Lucas-el-pato/FC-DRON-P3/README.md

# FC-DRON-P3 - P4
PCB para Control de vuelo de un Dron para la materia de Proyecto 3 y Proyecto 4 por Lucas Garcia e Hernan Ibarra
