Lucas-el-pato/FC-DRON-P3/Esquematico_1/Footprints/BMP388/BMP388.step

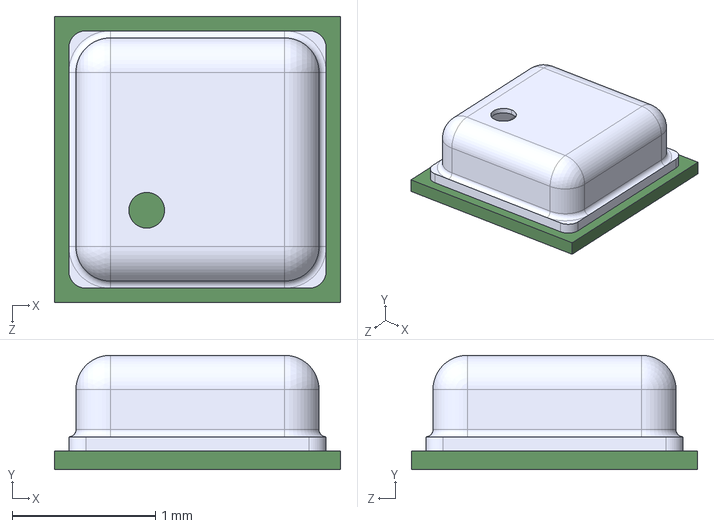
[picture p1: CAD file, 2026-02-21]
Esquematico_1/Footprints/BMP388/BMP388.step
2.00 x 0.8 x 2.00 mm
