Lucas-el-pato/FC-DRON-P3/Esquematico_1/Footprints/ICM_42688_P/ICM-42688-P.step

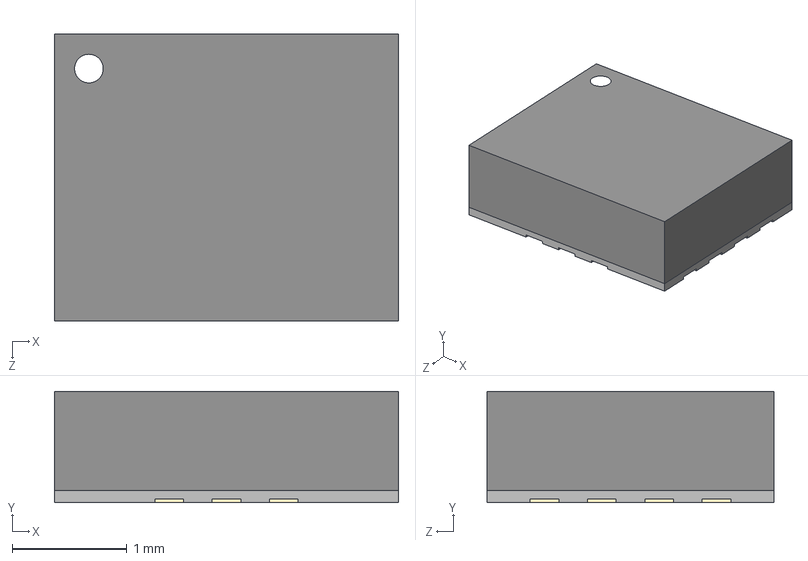
[picture p2: CAD file, 2026-02-24]
Esquematico_1/Footprints/ICM_42688_P/ICM-42688-P.step
3.00 x 0.97 x 2.50 mm
