Lucas-el-pato/FC-DRON-P3/Esquematico_1/Footprints/LIB_ABMM-8.000MHZ-D-4-T/ABMM-8.000MHZ-D-4-T/3D/ABMM-8.000MHZ-D-4-T.stp

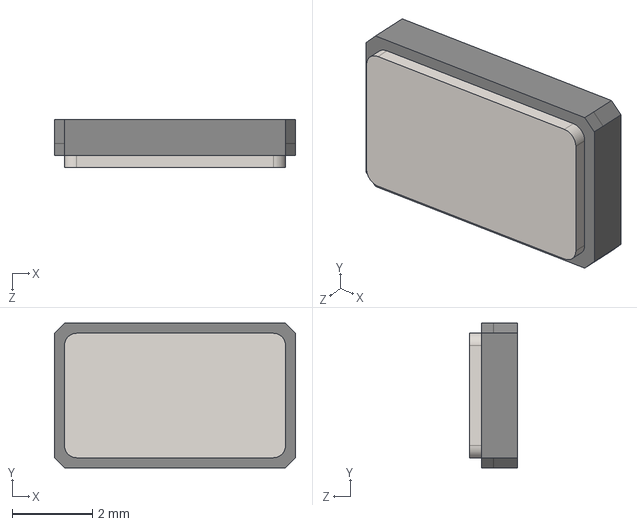
[picture p3: CAD file, 2026-03-03]
Esquematico_1/Footprints/LIB_ABMM-8.000MHZ-D-4-T/ABMM-8.000MHZ-D-4-T/3D/ABMM-8.000MHZ-D-4-T.stp
6.00 x 3.60 x 1.20 mm
