Lucas-el-pato/FC-DRON-P3/Esquematico_1/Footprints/LIB_AP2112K-3.3TRG1/AP2112K-3.3TRG1/3D/AP2112K-3.3TRG1.stp

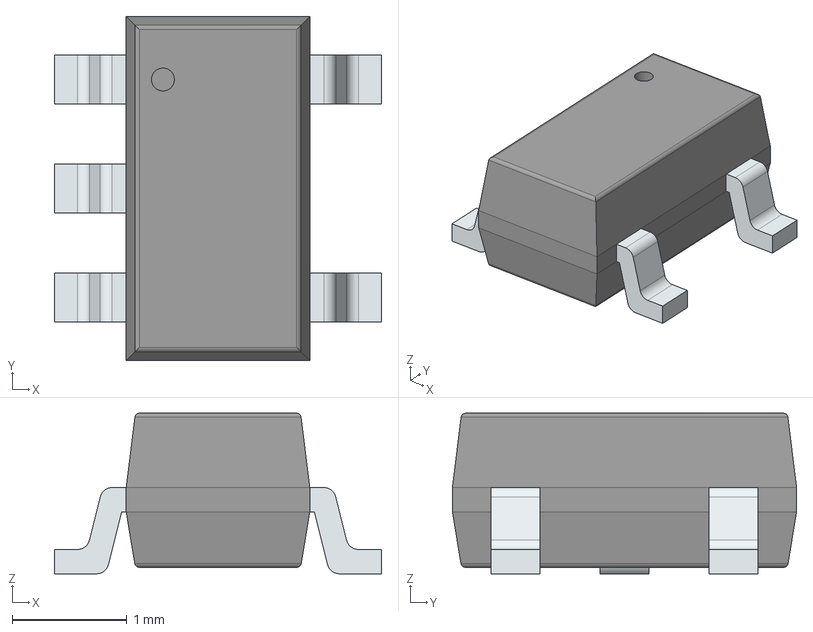
[picture p4: CAD file, 2026-03-10]
Esquematico_1/Footprints/LIB_AP2112K-3.3TRG1/AP2112K-3.3TRG1/3D/AP2112K-3.3TRG1.stp
2.85 x 3.00 x 1.40 mm
PinsArrayL
PinsArrayR
