Lucas-el-pato/FC-DRON-P3/Esquematico_1/Footprints/LIB_MAX-M10M-00B/MAX-M10M-00B/3D/MAX-M10M-00B.stp

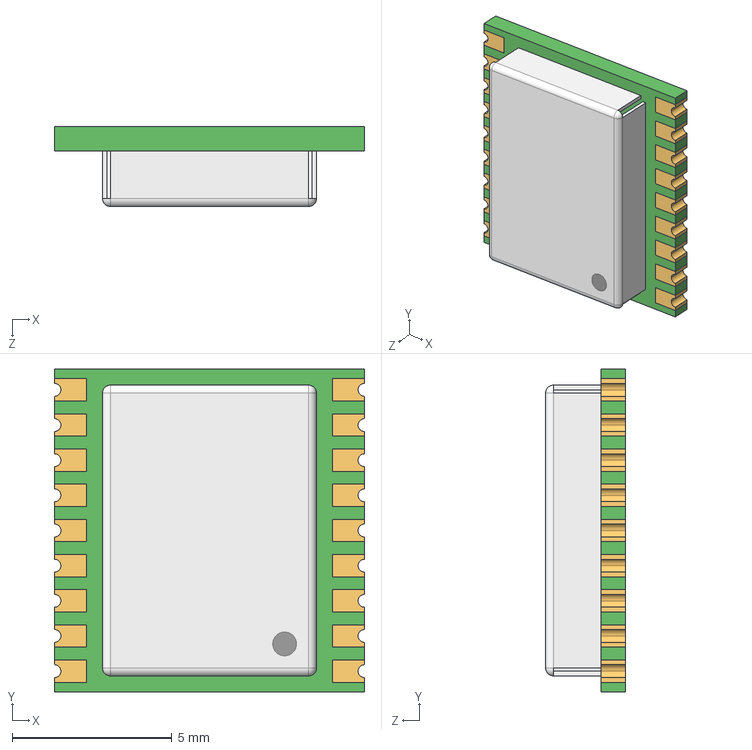
[picture p5: CAD file, 2026-02-21]
Esquematico_1/Footprints/LIB_MAX-M10M-00B/MAX-M10M-00B/3D/MAX-M10M-00B.stp
9.70 x 10.1 x 2.50 mm
