Lucas-el-pato/FC-DRON-P3/Esquematico_1/Footprints/LIB_USB4940-00-A/ul_2295018-2/c-2295018-2-b-3d.stp

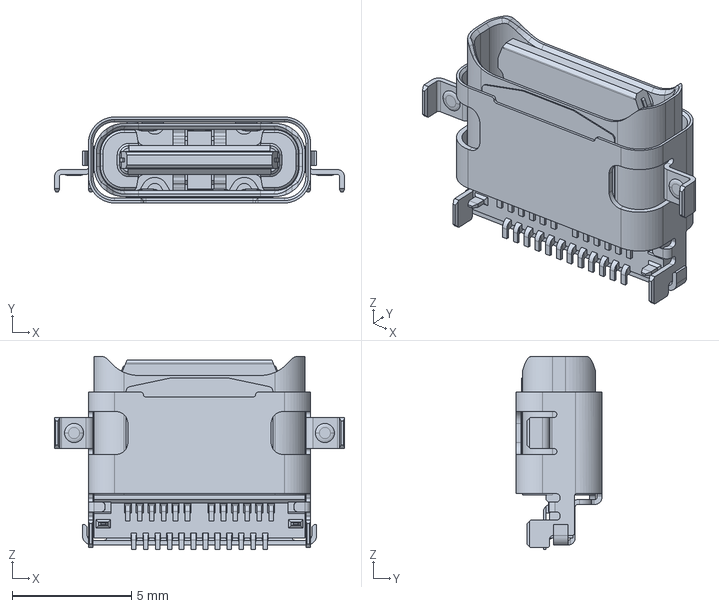
[picture p6: CAD file, 2026-03-16]
Esquematico_1/Footprints/LIB_USB4940-00-A/ul_2295018-2/c-2295018-2-b-3d.stp
12.1 x 3.60 x 8.10 mm
