Lucas-el-pato/FC-DRON-P3/Esquematico_1/Footprints/LIB_USB4940-00-A/USB4940-00-A/3D/USB4940-00-A.stp

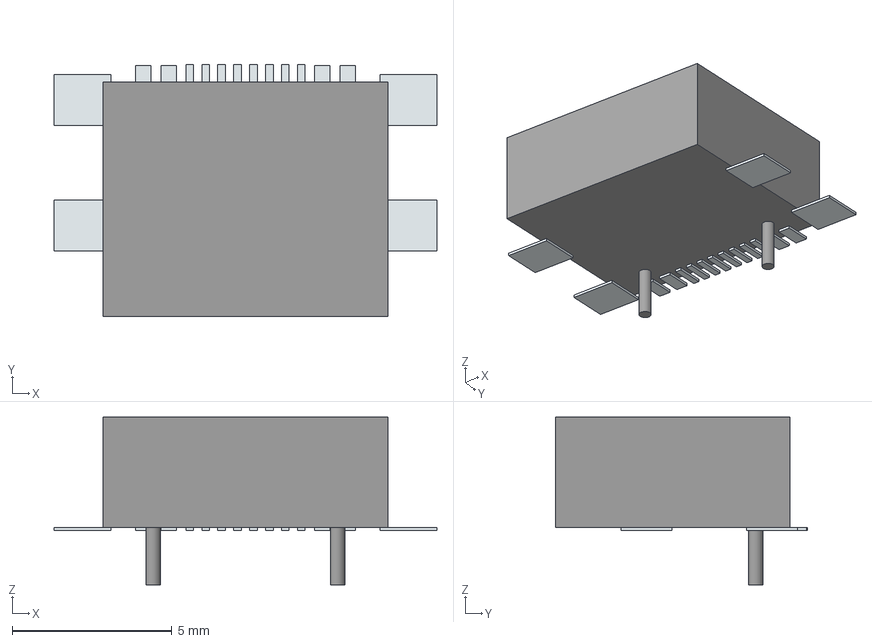
[picture p7: CAD file, 2026-03-11]
Esquematico_1/Footprints/LIB_USB4940-00-A/USB4940-00-A/3D/USB4940-00-A.stp
12.0 x 7.90 x 5.26 mm
Pins
Lugs
