Lucas-el-pato/FC-DRON-P3/Esquematico_1/Footprints/MAX_M10S_00B/MAX-M10S-00B.STEP

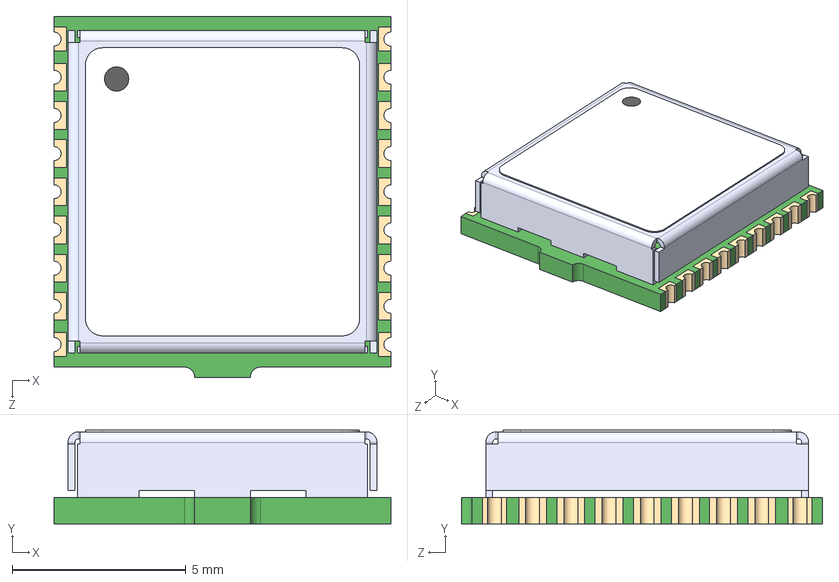
[picture p8: CAD file, 2026-03-06]
Esquematico_1/Footprints/MAX_M10S_00B/MAX-M10S-00B.STEP
9.70 x 2.70 x 10.4 mm
