Lucas-el-pato/FC-DRON-P3/Esquematico_1/Footprints/Tokmas ICM-42688-PC/LGA14_2P5X3X0P91_TDK.step

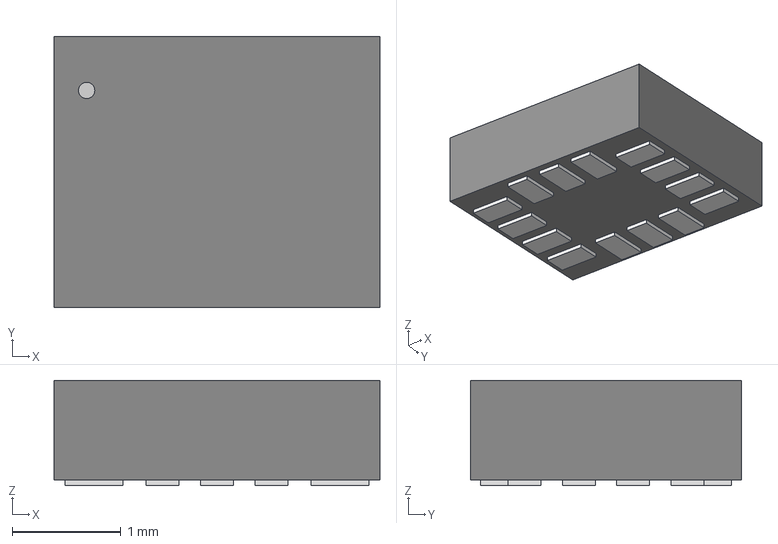
[picture p9: CAD file, 2026-03-16]
Esquematico_1/Footprints/Tokmas ICM-42688-PC/LGA14_2P5X3X0P91_TDK.step
3.00 x 2.49 x 0.968 mm
