Lucas-el-pato/FC-DRON-P3/Esquematico_1/Footprints/ul_ECS-80-12-30BQ-JES-TR/ECS-80-12_ECS.step

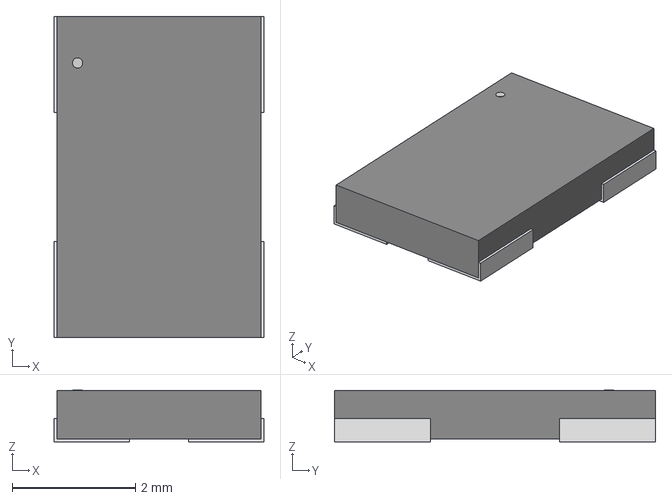
[picture p10: CAD file, 2026-03-10]
Esquematico_1/Footprints/ul_ECS-80-12-30BQ-JES-TR/ECS-80-12_ECS.step
3.40 x 5.21 x 0.841 mm
