Lucas-el-pato/FC-DRON-P3/Esquematico_1/Footprints/ul_LSM6DSV16XTR/LGA-14L_STM.step

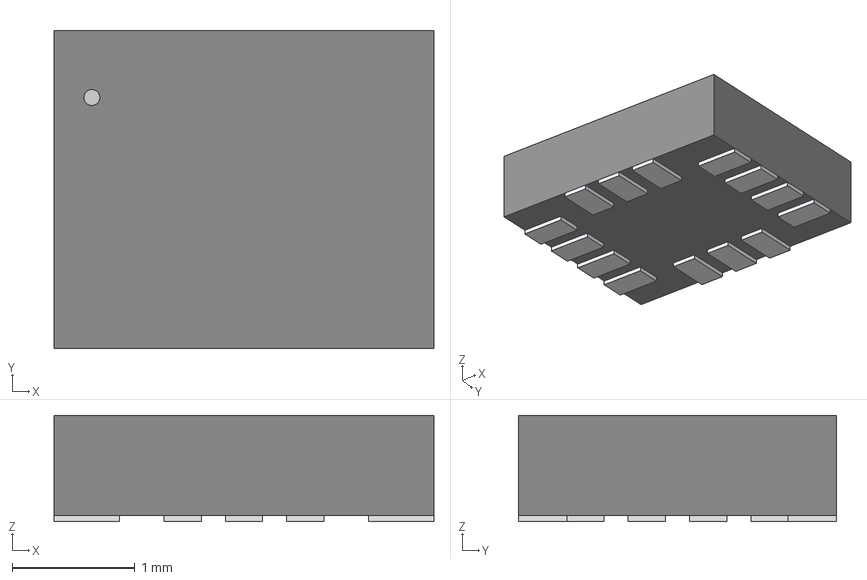
[picture p11: CAD file, 2026-04-01]
Esquematico_1/Footprints/ul_LSM6DSV16XTR/LGA-14L_STM.step
3.10 x 2.59 x 0.866 mm
