Lucas-el-pato/FC-DRON-P3/Esquematico_1/Footprints/ul_MMC5983MA/MMC5983MA_MEM.step

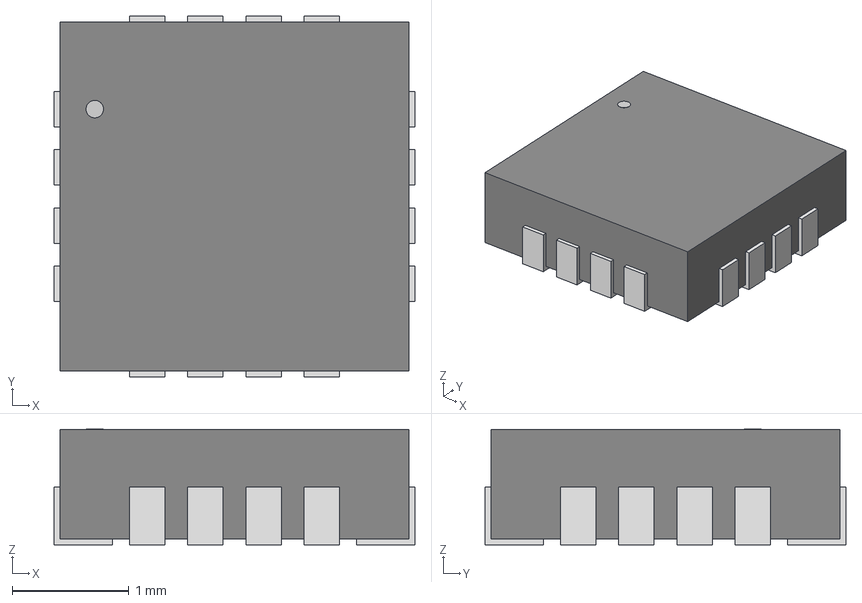
[picture p12: CAD file, 2026-03-29]
Esquematico_1/Footprints/ul_MMC5983MA/MMC5983MA_MEM.step
3.10 x 3.10 x 0.993 mm
