Lucas-el-pato/FC-DRON-P3/Esquematico_1/Footprints/ul_NX3215SA-32-768K-STD-MUA-9/ul_NX3215SA-32-768K-STD-MUA-9 (1)/XTAL_NX3215SA_NDK.step

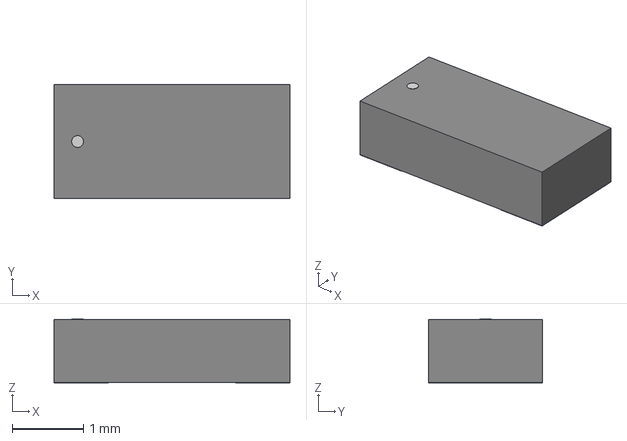
[picture p13: CAD file, 2026-03-10]
Esquematico_1/Footprints/ul_NX3215SA-32-768K-STD-MUA-9/ul_NX3215SA-32-768K-STD-MUA-9 (1)/XTAL_NX3215SA_NDK.step
3.30 x 1.60 x 0.892 mm
