Lucas-el-pato/FC-DRON-P3/Esquematico_1/Footprints/MOLEX 5033981892/ul_5033981892/5033981892.stp

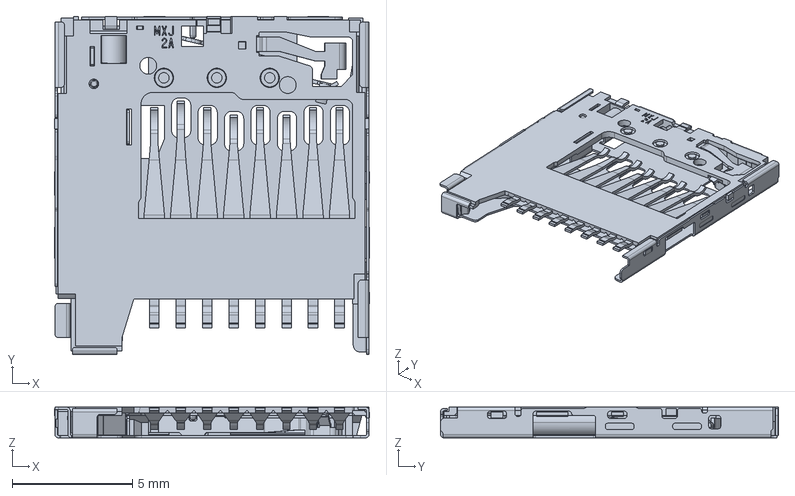
[picture p14: CAD file, 2026-03-16]
Esquematico_1/Footprints/MOLEX 5033981892/ul_5033981892/5033981892.stp
13.1 x 14.0 x 1.28 mm
