Lucas-el-pato/FC-DRON-P3/(list of files, cad)

Other CAD files:
Esquematico_1/Footprints/LIB_ABMM-8.000MHZ-D-4-T/ABMM-8.000MHZ-D-4-T/Allegro/abmm25000mhzb2t.psm
Esquematico_1/Footprints/LIB_ABMM-8.000MHZ-D-4-T/ABMM-8.000MHZ-D-4-T/DEHDL/abmm_8.000mhz_d_4_t/chips/chips.prt
Esquematico_1/Footprints/LIB_AP2112K-3.3TRG1/AP2112K-3.3TRG1/Allegro/sot95p285x140-5n.psm
Esquematico_1/Footprints/LIB_AP2112K-3.3TRG1/AP2112K-3.3TRG1/DEHDL/ap2112k_3.3trg1/chips/chips.prt
Esquematico_1/Footprints/LIB_USB4940-00-A/USB4940-00-A/Allegro/usb494000a.psm
Esquematico_1/Footprints/LIB_USB4940-00-A/USB4940-00-A/DEHDL/usb4940_00_a/chips/chips.prt
