Lucas-el-pato/FC-DRON-P3/(list of files, drawings)

Other design files:
Esquematico_1/Footprints/hanxia HX-TYPE-C 24P-1.6 USB C 3.2 REC, HORZ/HX-TYPE-C 24P-1.6 USB C 3.2 REC, HORZ1_HX-TYPE-C 24P-1.6 USB C 3.2 REC, HORZ.schdoc
Esquematico_1/Footprints/hanxia HX-TYPE-C 24P-1.6 USB C 3.2 REC, HORZ/k10/LGA-16_L3.0-W3.0-P0.50-BL_SQ.pcbdoc
Esquematico_1/Footprints/hanxia HX-TYPE-C 24P-1.6 USB C 3.2 REC, HORZ/k10/USB-C-SMD_C49261591.pcbdoc
Esquematico_1/Footprints/HYP 1TS003B-1400-3500A-CT/1TS003B-1400-3500A1_1TS003B-1400-3500A.schdoc
Esquematico_1/Footprints/HYP 1TS003B-1400-3500A-CT/k10/KEY-SMD_1TS003B.pcbdoc
Esquematico_1/Footprints/HYP 1TS003B-1400-3500A-CT/k10/LGA-16_L3.0-W3.0-P0.50-BL_SQ.pcbdoc
Esquematico_1/Footprints/LIB_AP2112K-3.3TRG1/AP2112K-3.3TRG1/Altium/AP2112K-3.3TRG1.SchLib
Esquematico_1/Footprints/LIB_AP2112K-3.3TRG1/AP2112K-3.3TRG1/Altium/SOT95P285X140-5N.PcbLib
Esquematico_1/Footprints/LIB_USB4940-00-A/USB4940-00-A/Altium/USB4940-00-A.SchLib
Esquematico_1/Footprints/LIB_USB4940-00-A/USB4940-00-A/Altium/USB494000A.PcbLib
Esquematico_1/Footprints/MOLEX 5033981892/503398-18921_503398-1892.schdoc
Esquematico_1/Footprints/MOLEX 5033981892/k10/LGA-16_L3.0-W3.0-P0.50-BL_SQ.pcbdoc
Esquematico_1/Footprints/MOLEX 5033981892/k10/TF-SMD_503398-1892.pcbdoc
Esquematico_1/Footprints/QMC5883P/k10/LGA-16_L3.0-W3.0-P0.50-BL_SQ.pcbdoc
Esquematico_1/Footprints/QMC5883P/QMC5883P1_QMC5883P.schdoc
Esquematico_1/Footprints/Tokmas ICM-42688-PC/ICM-42688-PC1_ICM-42688-PC.schdoc
Esquematico_1/Footprints/Tokmas ICM-42688-PC/k10/LGA-14_L3.0-W2.5-P0.50-TL.pcbdoc
