Lucas-el-pato/FC-DRON-P3/Esquematico_1/Esquematico_1.kicad_pcb

## KiCad design Esquematico_1/Esquematico_1.kicad_pcb (2026-04-23)

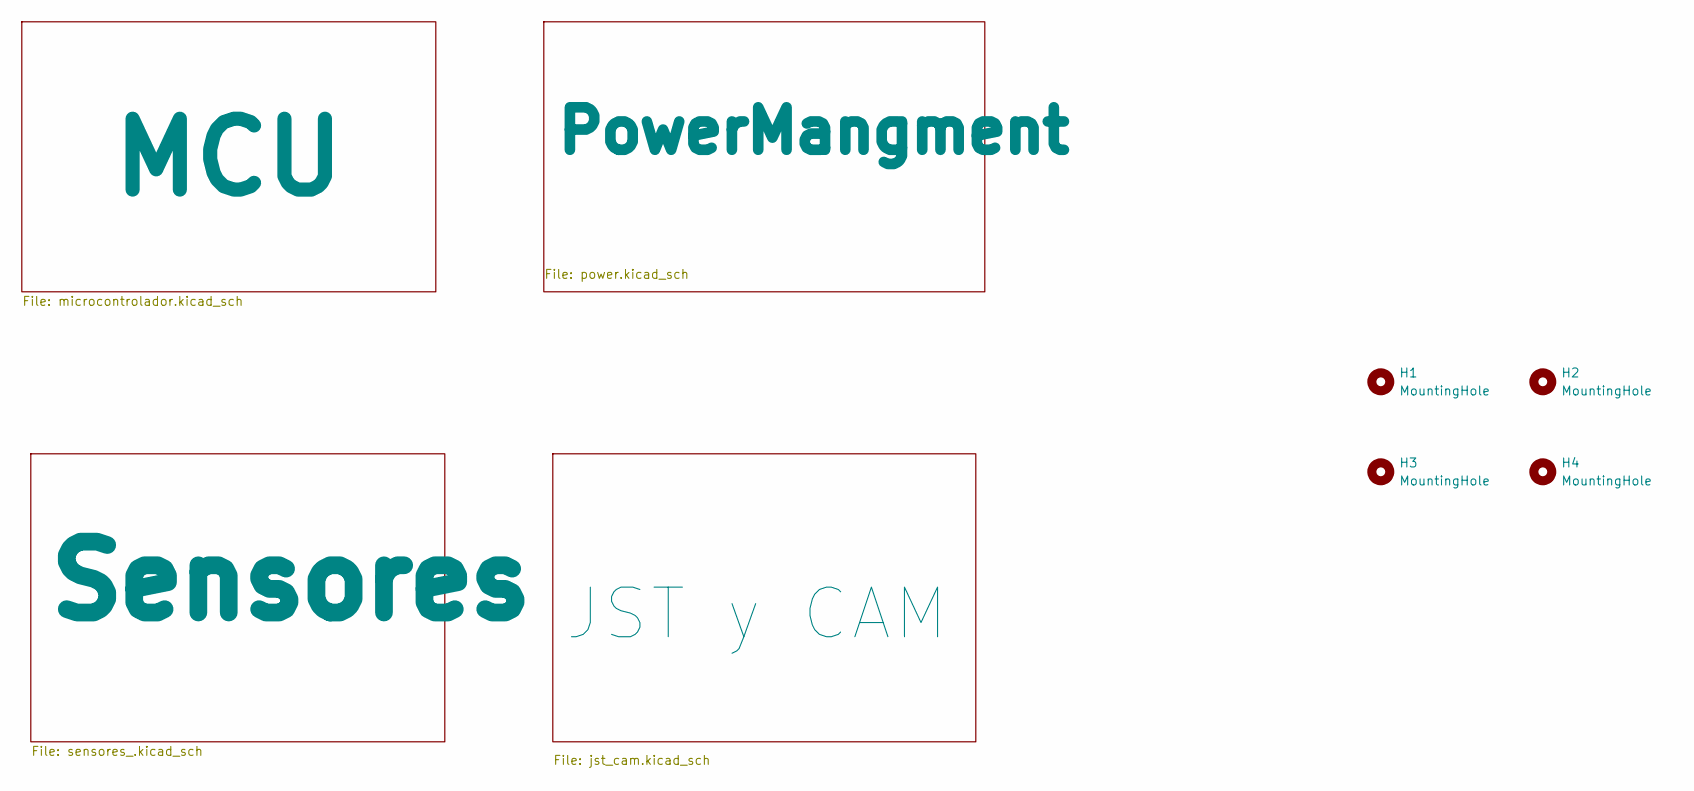
[picture p15: schematic Esquematico_1.kicad_sch]

Parts:
H1, H2, H3, H4: MountingHole; MountingHole_3.2mm_M3_Pad_Via

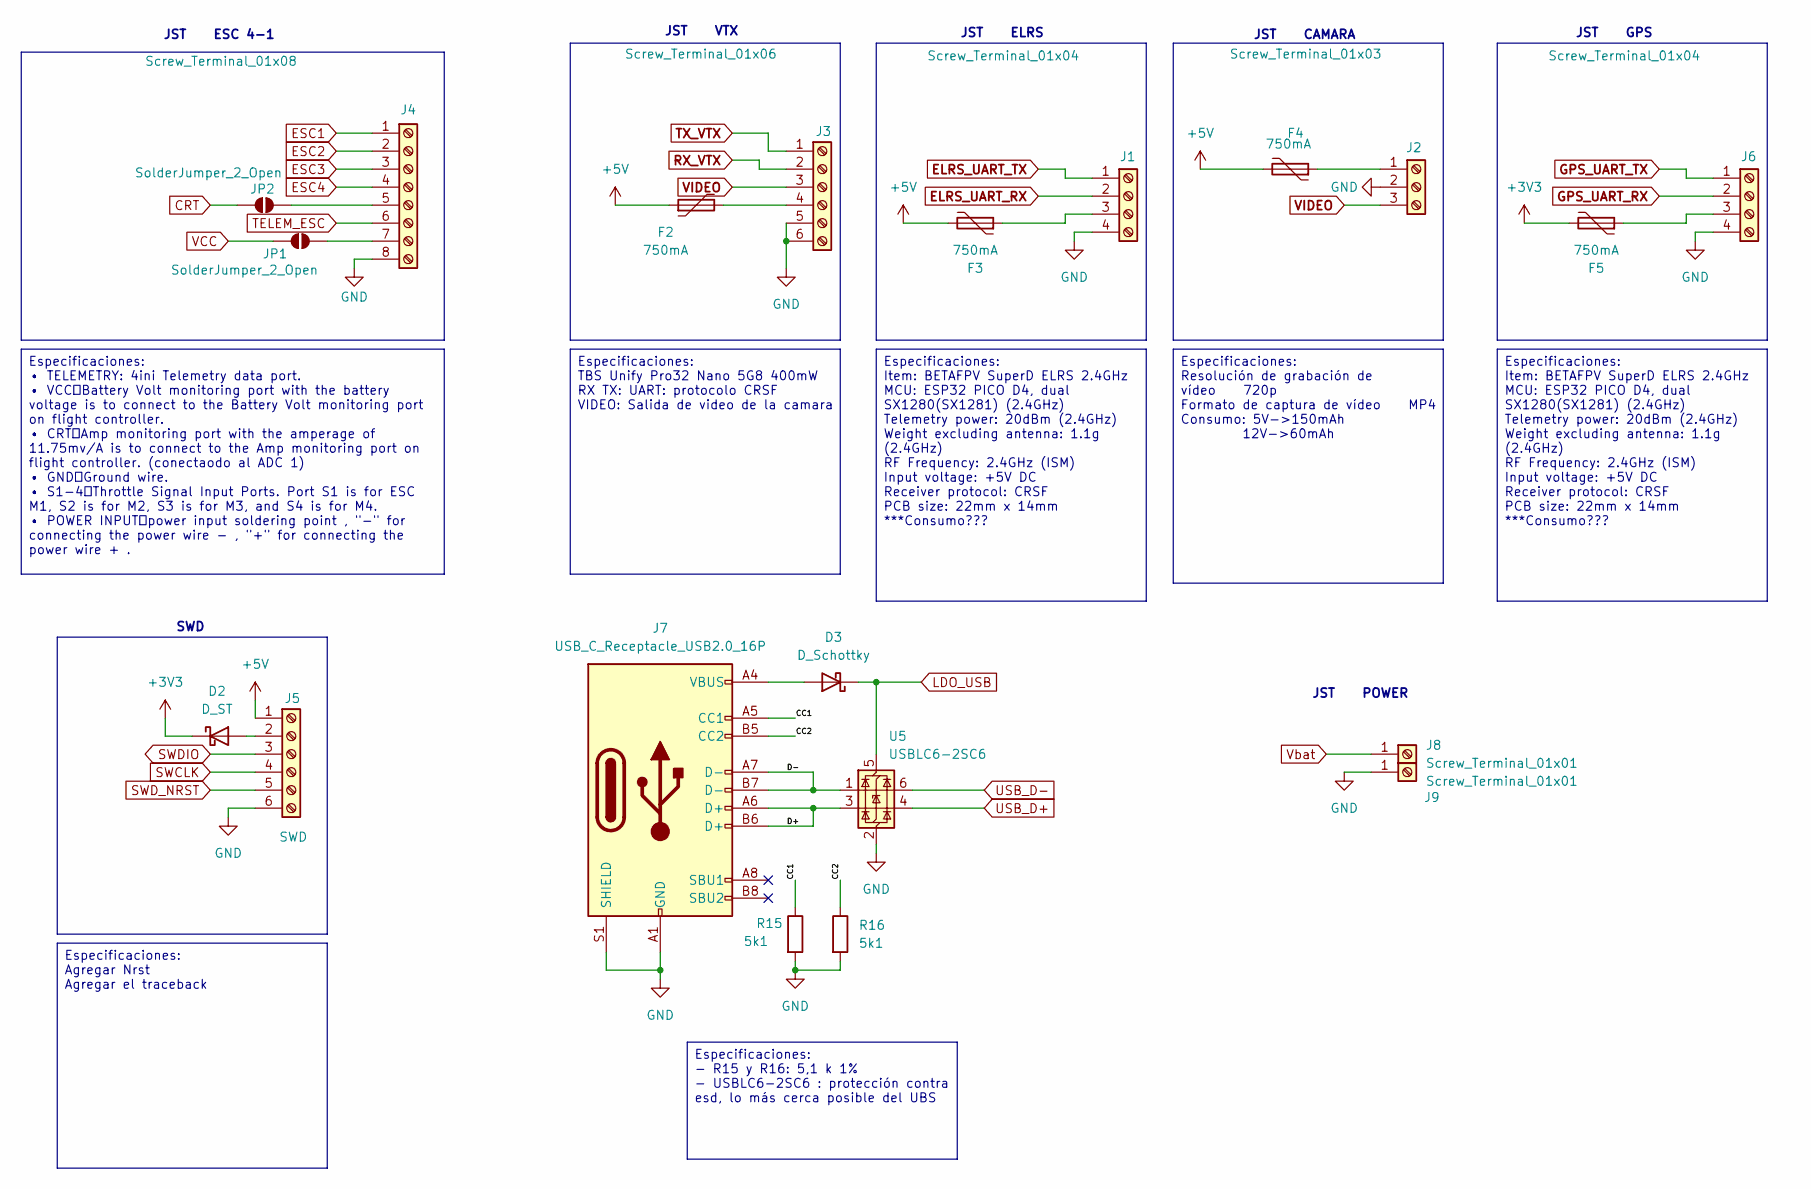
[picture p16: schematic jst_cam.kicad_sch]

Parts:
D2: D_ST; D_SOD-323_HandSoldering; LCSC Part Name C124187
D3: D_Schottky; D_SOD-323_HandSoldering; LCSC Part Name C124187
F2, F3, F4, F5: 750mA; C_0805_2012Metric_Pad1.18x1.45mm_HandSolder; LCSC Part Name C151146
J1, J6: Screw_Terminal_01x04; JST_SH_SM04B-SRSS-TB_1x04-1MP_P1.00mm_Horizontal; LCSC Part Name C160404
J2: Screw_Terminal_01x03; JST_SH_SM03B-SRSS-TB_1x03-1MP_P1.00mm_Horizontal; LCSC Part Name C160403
J3: Screw_Terminal_01x06; JST_SH_SM06B-SRSS-TB_1x06-1MP_P1.00mm_Horizontal; LCSC Part Name C160405
J4: Screw_Terminal_01x08; JST_SH_SM08B-SRSS-TB_1x08-1MP_P1.00mm_Horizontal; LCSC Part Name C160407
J5: SWD; PinHeader_1x06_P1.00mm_Vertical_SMD_Pin1Left
J7: USB_C_Receptacle_USB2.0_16P; USB494000A
J8, J9: Screw_Terminal_01x01; TestPoint_Pad_2.5x2.5mm
JP1, JP2: SolderJumper_2_Open; SolderJumper-2_P1.3mm_Open_RoundedPad1.0x1.5mm
R15, R16: 5k1; R_0805_2012Metric_Pad1.20x1.40mm_HandSolder; LCSC Part Name C2907269
U5: USBLC6-2SC6; SOT-23-6; LCSC Part Name C2969755

Connections:
+3V3: D2.1 (K), F5.2; also elsewhere on the board
/JST y CAM/CC1: J7.A5 (CC1), R15.1
/JST y CAM/CC2: J7.B5 (CC2), R16.1
/JST y CAM/D+: J7.A6 (D+), J7.B6 (D+), U5.3 (I/O2)
/JST y CAM/D-: J7.A7 (D-), J7.B7 (D-), U5.1 (I/O1)
CRT: JP2.2 (B); also elsewhere on the board
ELRS_UART_RX: J1.2; also elsewhere on the board
ELRS_UART_TX: J1.1; also elsewhere on the board
ESC1: J4.1; also elsewhere on the board
ESC2: J4.2; also elsewhere on the board
ESC3: J4.3; also elsewhere on the board
ESC4: J4.4; also elsewhere on the board
GND: J1.4, J2.2, J3.5, J3.6, J4.8, J5.6, J6.4, J7.A1 (GND), J7.A12 (GND), J7.B1 (GND), J7.B12 (GND), J7.S1 (SHIELD), J9.1, R15.2, R16.2, U5.2 (GND); also elsewhere on the board
GPS_UART_RX: J6.2; also elsewhere on the board
GPS_UART_TX: J6.1; also elsewhere on the board
LDO_USB: D3.1 (K), F2.1, F3.2, F4.2, J5.1, U5.5 (VBUS); also elsewhere on the board
unnamed: D2.2 (A), J5.2
unnamed: D3.2 (A), J7.A4 (VBUS), J7.A9 (VBUS), J7.B4 (VBUS), J7.B9 (VBUS)
unnamed: F3.1, J1.3
unnamed: F4.1, J2.1
unnamed: F2.2, J3.4
unnamed: J4.5, JP2.1 (A)
unnamed: J4.7, JP1.1 (A)
unnamed: F5.1, J6.3
RX_VTX: J3.2; also elsewhere on the board
SWCLK: J5.4; also elsewhere on the board
SWDIO: J5.3; also elsewhere on the board
SWD_NRST: J5.5; also elsewhere on the board
TELEM_ESC: J4.6; also elsewhere on the board
TX_VTX: J3.1; also elsewhere on the board
USB_D+: U5.4 (I/O2); also elsewhere on the board
USB_D-: U5.6 (I/O1); also elsewhere on the board
VCC: J8.1, JP1.2 (B); also elsewhere on the board
VIDEO: J2.3, J3.3

Notes on the sheet:
JST GPS
JST CAMARA
JST POWER
JST VTX
JST ELRS
SWD
JST ESC 4-1
Especificaciones: Agregar Nrst Agregar el traceback
Especificaciones: Item: BETAFPV SuperD ELRS 2.4GHz MCU: ESP32 PICO D4, dual SX1280(SX1281) (2.4GHz) Telemetry power: 20dBm (2.4GHz) Weight excluding antenna: 1.1g (2.4GHz) RF Frequency: 2.4GHz (ISM) Input voltage: +5V DC Receiver protocol: CRSF PCB size: 22mm x 14mm ***Consumo???
Especificaciones: Resolución de grabación de vídeo 720p Formato de captura de vídeo MP4 Consumo: 5V->150mAh 12V->60mAh
Especificaciones: - R15 y R16: 5,1 k 1% - USBLC6-2SC6 : protección contra esd, lo más cerca posible del UBS
Especificaciones: TBS Unify Pro32 Nano 5G8 400mW RX TX: UART: protocolo CRSF VIDEO: Salida de video de la camara
Especificaciones: • TELEMETRY: 4ini Telemetry data port. • VCC：Battery Volt monitoring port with the battery voltage is to connect to the Battery Volt monitoring port on flight controller. • CRT：Amp monitoring port with the amperage of 11.75mv/A is to connect to the Amp monitoring port on flight co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

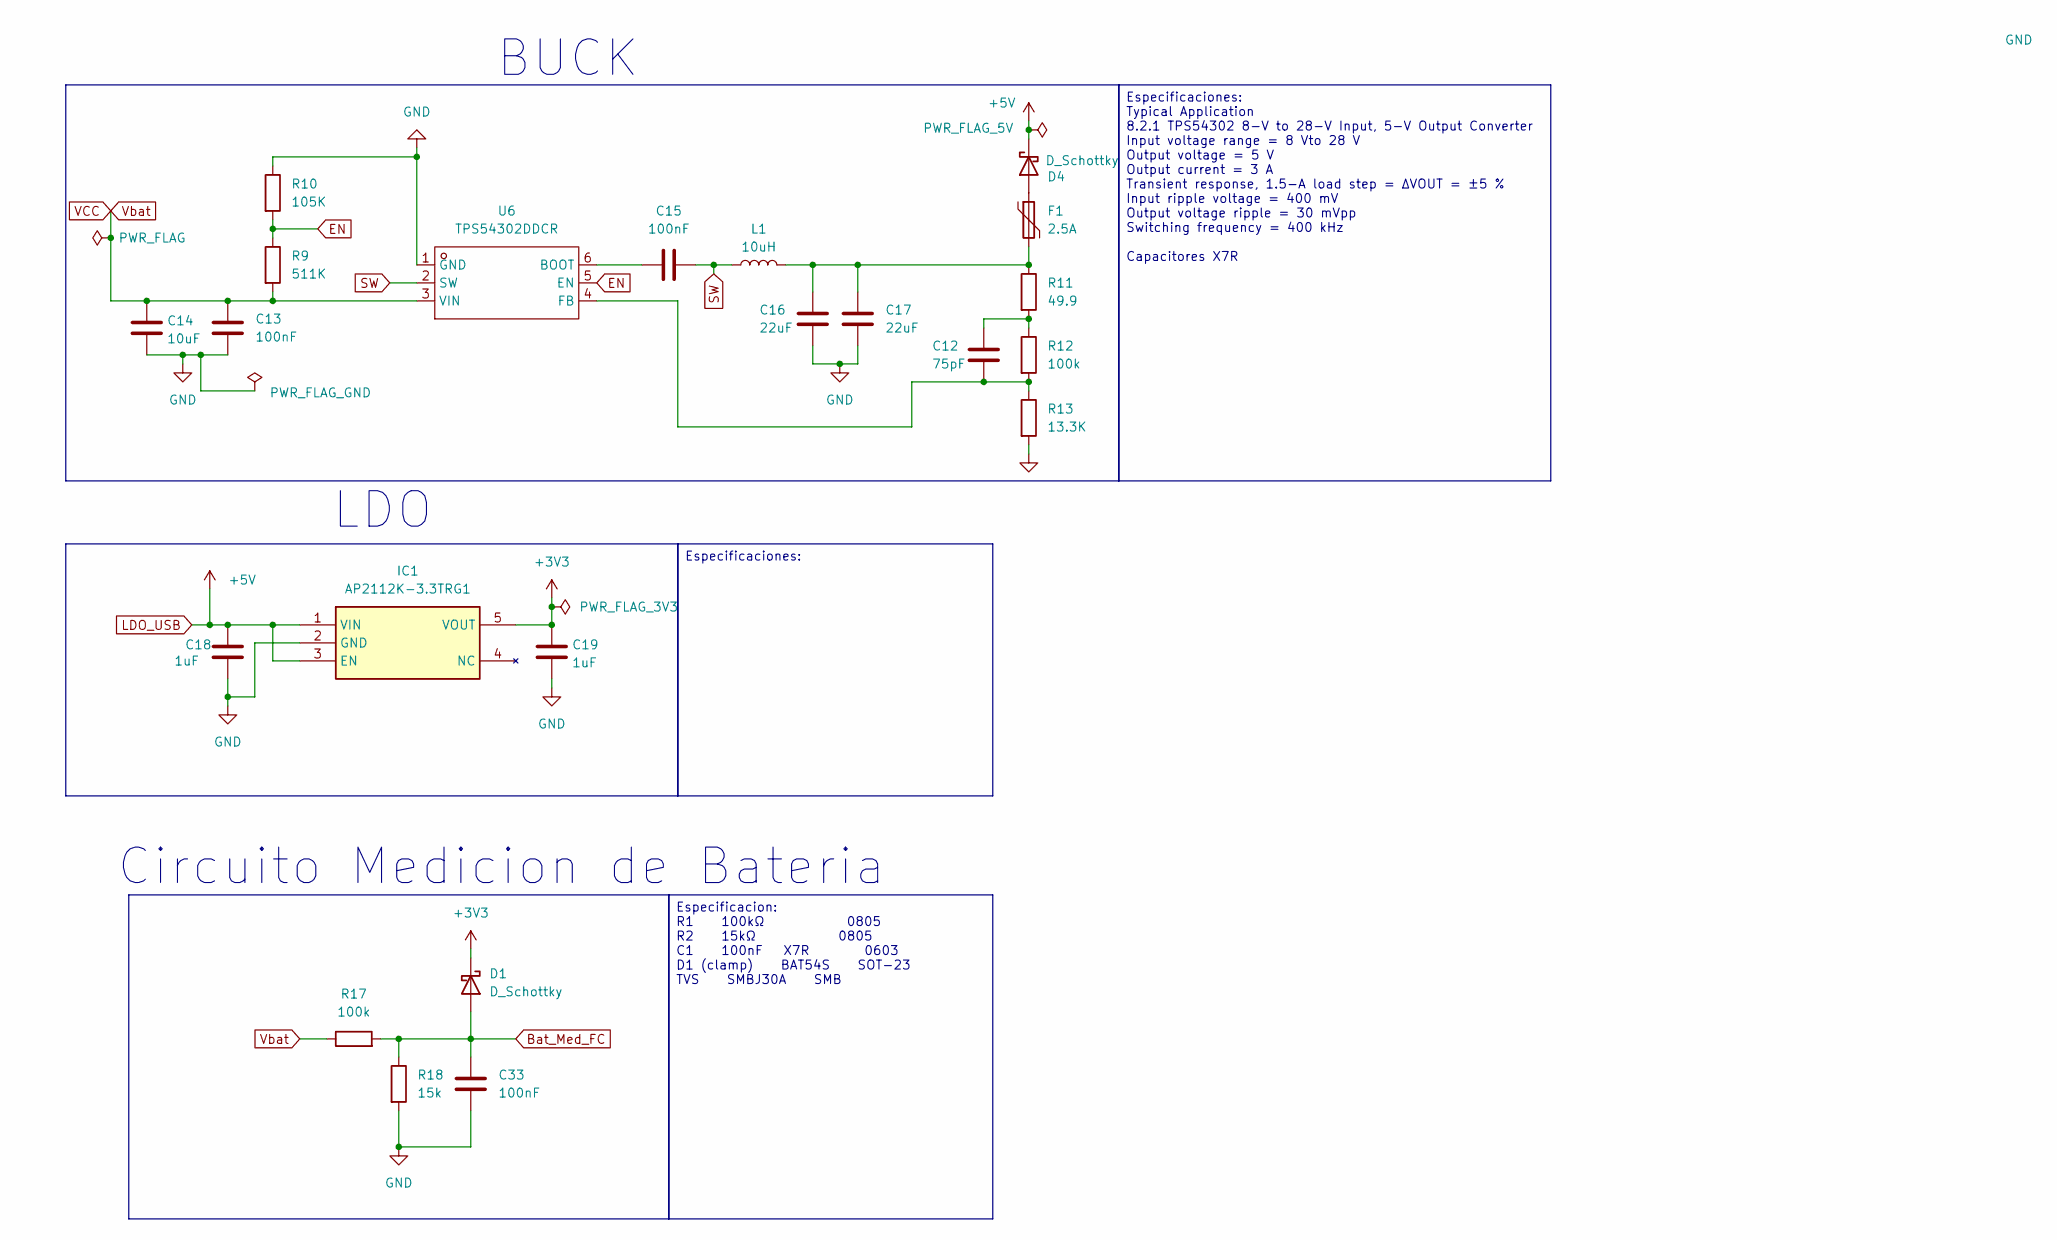
[picture p17: schematic power.kicad_sch]

Parts:
C12: 75pF; C_0805_2012Metric_Pad1.18x1.45mm_HandSolder; LCSC Part Name C113832
C13, C15, C33: 100nF; C_0805_2012Metric_Pad1.18x1.45mm_HandSolder; LCSC Part Name C1711
C14: 10uF; C_0805_2012Metric_Pad1.18x1.45mm_HandSolder; LCSC Part Name C237493
C16, C17: 22uF; C_0805_2012Metric_Pad1.18x1.45mm_HandSolder; LCSC Part Name C907991
C18, C19: 1uF; C_0805_2012Metric_Pad1.18x1.45mm_HandSolder; LCSC Part Name C28323
D1, D4: D_Schottky; D_SOD-323_HandSoldering; LCSC Part Name C124187
F1: 2.5A; Fuse_1812_4532Metric_Pad1.30x3.40mm_HandSolder; LCSC Part Name C210838
IC1: AP2112K-3.3TRG1; SOT95P285X140-5N; Mouser Part Number 621-AP2112K-3.3TRG1
L1: 10uH; L_KOHERelec_MDA7030
R9: 511K; R_0805_2012Metric_Pad1.20x1.40mm_HandSolder; LCSC Part Name C5159719
R10: 105K; R_0805_2012Metric_Pad1.20x1.40mm_HandSolder; LCSC Part Name C3000727
R11: 49.9; R_0805_2012Metric_Pad1.20x1.40mm_HandSolder; LCSC Part Name C2933455
R12, R17: 100k; R_0805_2012Metric_Pad1.20x1.40mm_HandSolder; LCSC Part Name C149504
R13: 13.3K; R_0805_2012Metric_Pad1.20x1.40mm_HandSolder; LCSC Part Name C2930408
R18: 15k; R_0805_2012Metric_Pad1.20x1.40mm_HandSolder; LCSC Part Name C2930170
U6: TPS54302DDCR; SOT-23-6_L2.9-W1.6-P0.95-LS2.8-BL; Manufacturer Part TPS54302DDCR; LCSC Part Name C311983

Connections:
+3V3: C19.2, D1.1 (K), IC1.5 (VOUT); also elsewhere on the board
Bat_Med_FC: C33.1, D1.2 (A), R17.2, R18.1; also elsewhere on the board
EN: R9.1, R10.2, U6.5 (EN)
GND: C13.1, C14.1, C16.1, C17.1, C18.1, C19.1, C33.2, IC1.2 (GND), R10.1, R13.2, R18.2, U6.1 (GND); also elsewhere on the board
LDO_USB: C18.2, D4.1 (K), IC1.1 (VIN), IC1.3 (EN); also elsewhere on the board
unnamed: C12.1, R11.2, R12.1
unnamed: C16.2, C17.2, F1.2, L1.2, R11.1
unnamed: D4.2 (A), F1.1
unnamed: C15.1, U6.6 (BOOT)
unnamed: C12.2, R12.2, R13.1, U6.4 (FB)
SW: C15.2, L1.1, U6.2 (SW)
VCC: C13.2, C14.2, R9.2, R17.1, U6.3 (VIN); also elsewhere on the board

Notes on the sheet:
BUCK
Circuito Medicion de Bateria
LDO
Especificacion: R1 100kΩ 0805 R2 15kΩ 0805 C1 100nF X7R 0603 D1 (clamp) BAT54S SOT-23 TVS SMBJ30A SMB
Especificaciones:
Especificaciones: Typical Application 8.2.1 TPS54302 8-V to 28-V Input, 5-V Output Converter Input voltage range = 8 Vto 28 V Output voltage = 5 V Output current = 3 A Transient response, 1.5-A load step = ΔVOUT = ±5 % Input ripple voltage = 400 mV Output voltage ripple = 30 mVpp Switching frequenc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

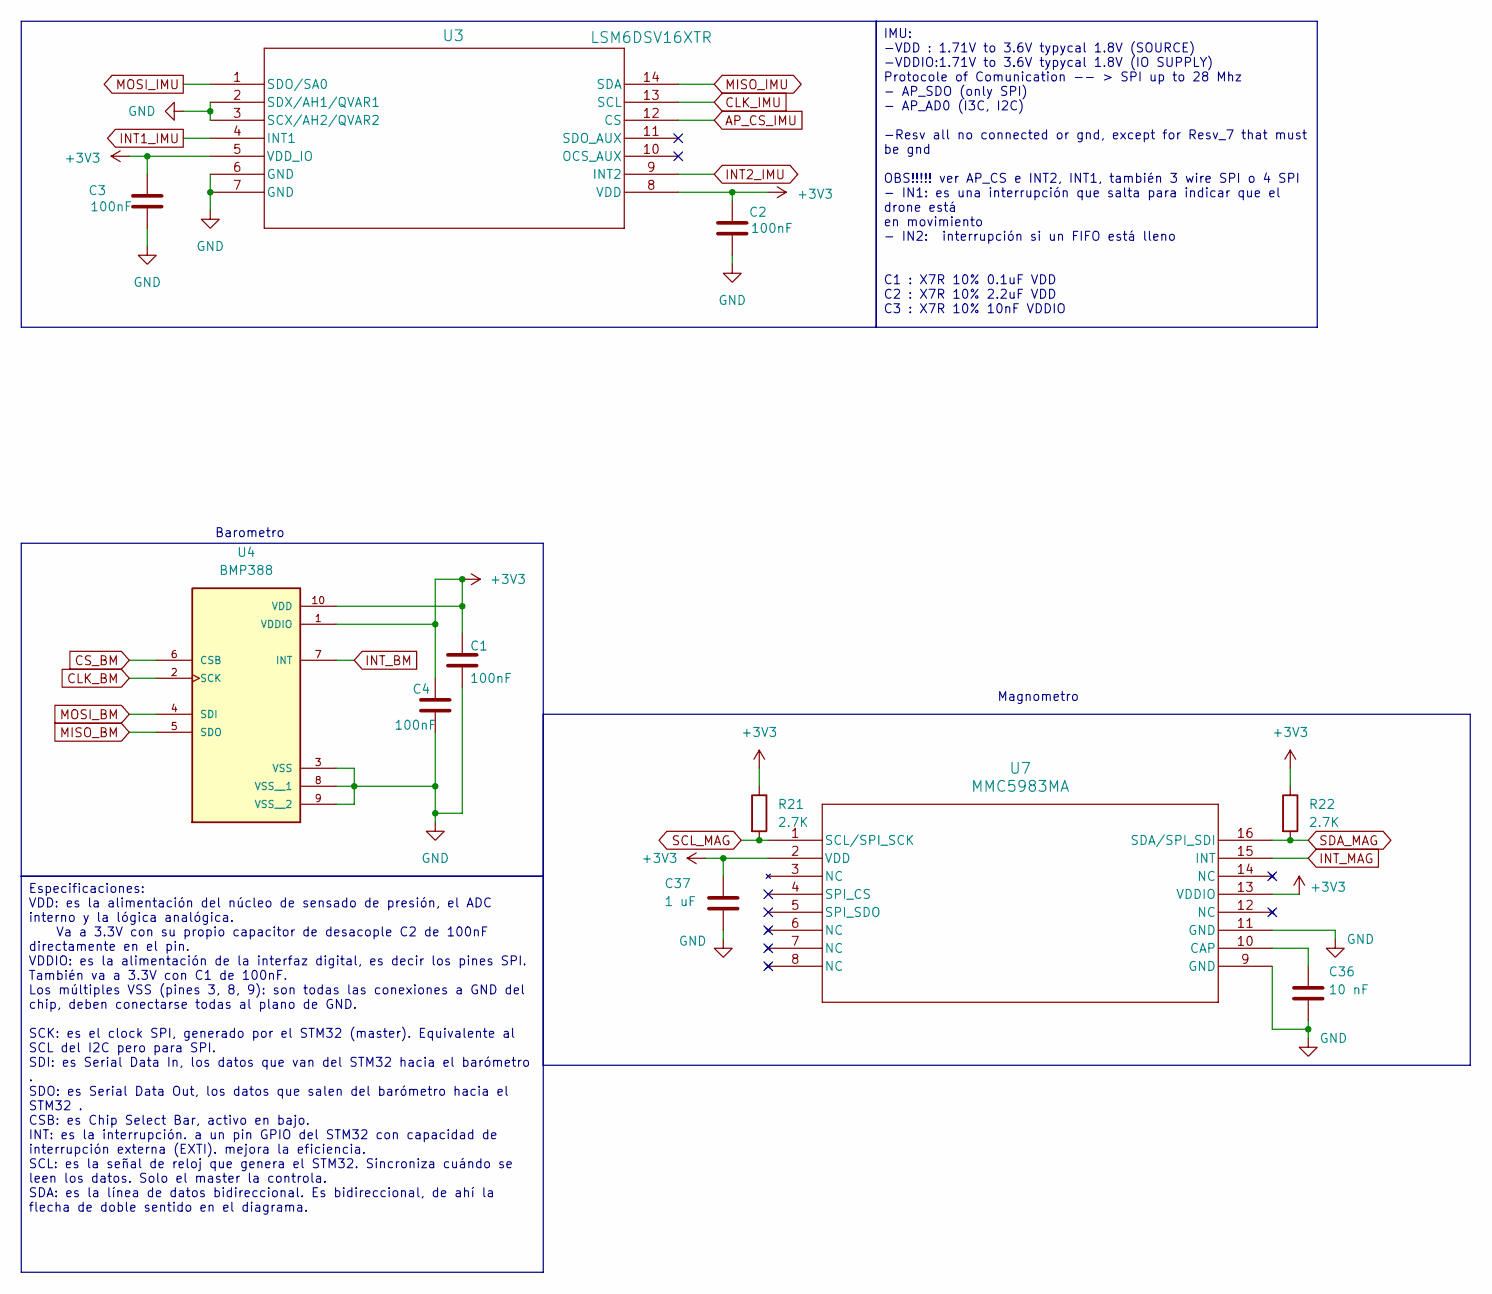
[picture p18: schematic sensores_.kicad_sch]

Parts:
C1, C2, C3, C4: 100nF; C_0603_1608Metric_Pad1.08x0.95mm_HandSolder; LCSC Part Name C1591
C36: 10 nF; C_0603_1608Metric_Pad1.08x0.95mm_HandSolder; LCSC Part Name C1589
C37: 1 uF; C_0603_1608Metric_Pad1.08x0.95mm_HandSolder; LCSC Part Name C29936
R21, R22: 2.7K; R_0805_2012Metric_Pad1.20x1.40mm_HandSolder
U3: LSM6DSV16XTR; LGA-14L_STM; LCSC Part Name C5267406
U4: BMP388; PQFN50P200X200X80-10N; PARTREV 1.1; LCSC Part Name C779278
U7: MMC5983MA; MMC5983MA_MEM; LCSC Part Name C404329

Connections:
+3V3: C1.1, C2.1, C3.1, C4.1, C37.1, R21.1, R22.1, U3.5 (VDD_IO), U3.8 (VDD), U4.1 (VDDIO), U4.10 (VDD), U7.2 (VDD), U7.13 (VDDIO); also elsewhere on the board
AP_CS_IMU: U3.12 (CS); also elsewhere on the board
CLK_BM: U4.2 (SCK); also elsewhere on the board
CLK_IMU: U3.13 (SCL); also elsewhere on the board
CS_BM: U4.6 (CSB); also elsewhere on the board
GND: C1.2, C2.2, C3.2, C4.2, C36.2, C37.2, U3.2 (SDX/AH1/QVAR1), U3.3 (SCX/AH2/QVAR2), U3.6 (GND), U3.7 (GND), U4.3 (VSS), U4.8 (VSS__1), U4.9 (VSS__2), U7.9 (GND), U7.11 (GND); also elsewhere on the board
INT1_IMU: U3.4 (INT1); also elsewhere on the board
INT2_IMU: U3.9 (INT2); also elsewhere on the board
INT_BM: U4.7 (INT); also elsewhere on the board
INT_MAG: U7.15 (INT); also elsewhere on the board
MISO_BM: U4.5 (SDO); also elsewhere on the board
MISO_IMU: U3.14 (SDA); also elsewhere on the board
MOSI_BM: U4.4 (SDI); also elsewhere on the board
MOSI_IMU: U3.1 (SDO/SA0); also elsewhere on the board
unnamed: C36.1, U7.10 (CAP)
SCL_MAG: R21.2, U7.1 (SCL/SPI_SCK); also elsewhere on the board
SDA_MAG: R22.2, U7.16 (SDA/SPI_SDI); also elsewhere on the board

Notes on the sheet:
Barometro
Magnometro
Especificaciones: VDD: es la alimentación del núcleo de sensado de presión, el ADC interno y la lógica analógica. Va a 3.3V con su propio capacitor de desacople C2 de 100nF directamente en el pin. VDDIO: es la alimentación de la interfaz digital, es decir los pines SPI. También va a 3.3V con C1 de 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
IMU: -VDD : 1.71V to 3.6V typycal 1.8V (SOURCE) -VDDIO:1.71V to 3.6V typycal 1.8V (IO SUPPLY) Protocole of Comunication -- > SPI up to 28 Mhz - AP_SDO (only SPI) - AP_AD0 (I3C, I2C) -Resv all no connected or gnd, except for Resv_7 that must be gnd OBS!!!!! ver AP_CS e INT2, INT1, también 3 wire SPI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

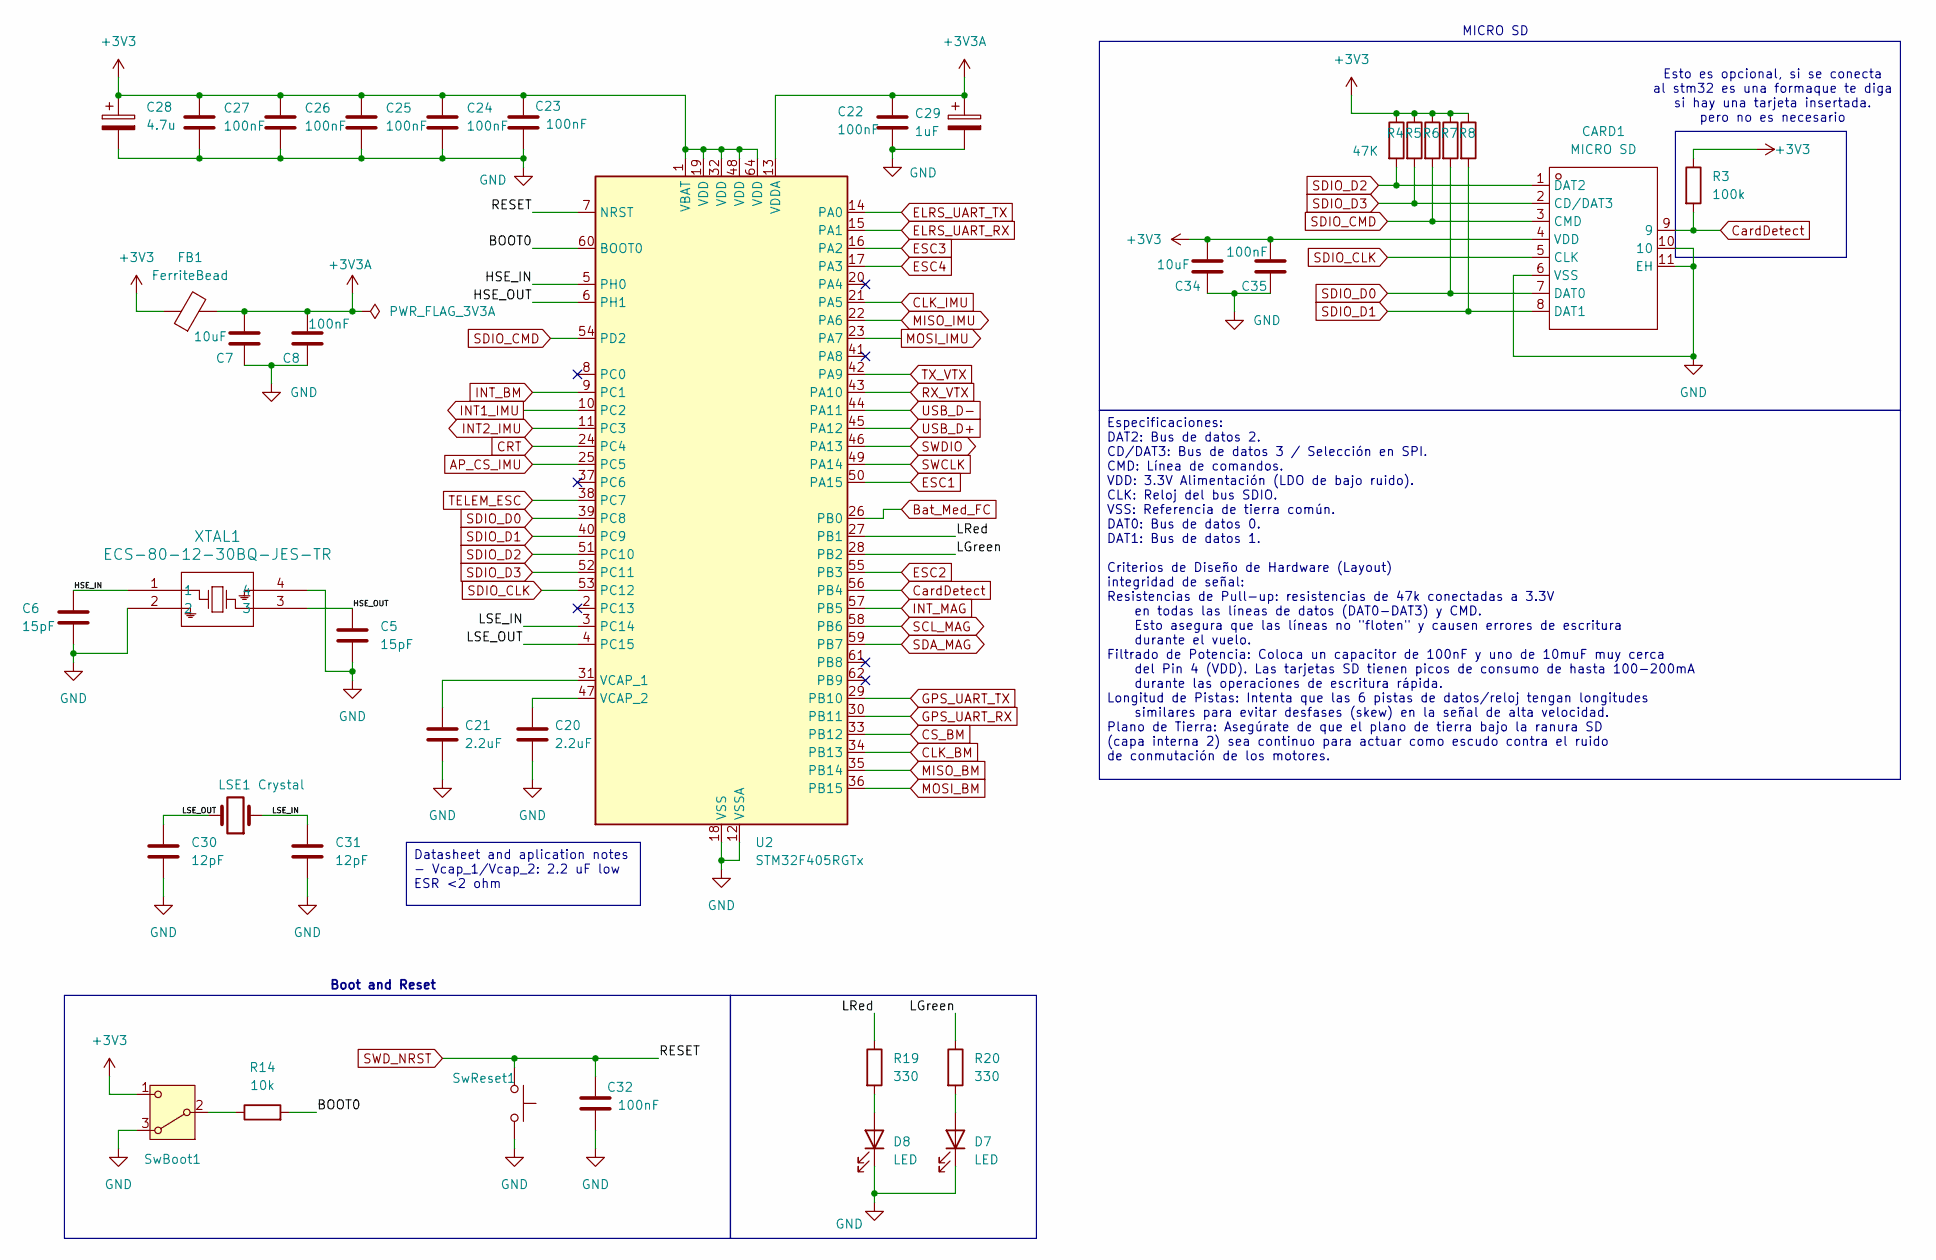
[picture p19: schematic microcontrolador.kicad_sch]

Parts:
C5, C6: 15pF; C_0603_1608Metric_Pad1.08x0.95mm_HandSolder; LCSC Part Name C1644
C7: 10uF; C_0805_2012Metric_Pad1.18x1.45mm_HandSolder; LCSC Part Name C237493
C8, C24, C26: 100nF; C_0805_2012Metric_Pad1.18x1.45mm_HandSolder; LCSC Part Name C1711
C20, C21: 2.2uF; C_0805_2012Metric_Pad1.18x1.45mm_HandSolder; LCSC Part Name C19110
C22, C23, C25, C27, C32, C35: 100nF; C_0603_1608Metric_Pad1.08x0.95mm_HandSolder; LCSC Part Name C1591
C28: 4.7u; C_0805_2012Metric_Pad1.18x1.45mm_HandSolder; LCSC Part Name C98195
C29: 1uF; C_0805_2012Metric_Pad1.18x1.45mm_HandSolder; LCSC Part Name C28323
C30, C31: 12pF; C_0603_1608Metric_Pad1.08x0.95mm_HandSolder; LCSC Part Name C38523
C34: 10uF; C_0603_1608Metric_Pad1.08x0.95mm_HandSolder; LCSC Part Name C22399626
CARD1: MICRO SD; TF-SMD_503398-1892; LCSC Part Name C428492
D7: LED; LED_0805_2012Metric_Pad1.15x1.40mm_HandSolder; LCSC Part Name C965815
D8: LED; LED_0805_2012Metric_Pad1.15x1.40mm_HandSolder; LCSC Part Name C965812
FB1: FerriteBead; C_0805_2012Metric_Pad1.18x1.45mm_HandSolder
LSE1: Crystal; XTAL_NX3215SA_NDK; LCSC Part Name C519280
R3: 100k; R_0805_2012Metric_Pad1.20x1.40mm_HandSolder; LCSC Part Name C149504
R4, R5, R6, R7, R8: 47K; R_0805_2012Metric_Pad1.20x1.40mm_HandSolder
R14: 10k; R_0805_2012Metric_Pad1.20x1.40mm_HandSolder
R19, R20: 330; R_0805_2012Metric_Pad1.20x1.40mm_HandSolder
SwBoot1: SW_Nidec_CAS-120A1; Nidec_Copal_CAS-120A; LCSC Part Name C5962834
SwReset1: SW_Push; SW_Push_SPST_NO_Alps_SKRK; LCSC Part Name C49234124
U2: STM32F405RGTx; LQFP-64_10x10mm_P0.5mm; LCSC Part Name C15742
XTAL1: ECS-80-12-30BQ-JES-TR; ECS-80-12_ECS

Connections:
+3V3: C23.1, C24.1, C25.1, C26.1, C27.1, C28.1, C34.2, C35.2, CARD1.4 (VDD), FB1.1, R3.1, R4.1, R5.1, R6.1, R7.1, R8.1, SwBoot1.1 (C), U2.1 (VBAT), U2.19 (VDD), U2.32 (VDD), U2.48 (VDD), U2.64 (VDD); also elsewhere on the board
+3V3A: C7.2, C8.2, C22.1, C29.1, FB1.2, U2.13 (VDDA)
/MCU/BOOT0: R14.2, U2.60 (BOOT0)
/MCU/HSE_IN: C6.1, U2.5 (PH0), XTAL1.1
/MCU/HSE_OUT: C5.1, U2.6 (PH1), XTAL1.3
/MCU/LGreen: R20.1, U2.28 (PB2)
/MCU/LRed: R19.1, U2.27 (PB1)
/MCU/LSE_IN: C31.1, LSE1.1, U2.3 (PC14)
/MCU/LSE_OUT: C30.1, LSE1.2, U2.4 (PC15)
AP_CS_IMU: U2.25 (PC5); also elsewhere on the board
Bat_Med_FC: U2.26 (PB0); also elsewhere on the board
CLK_BM: U2.34 (PB13); also elsewhere on the board
CLK_IMU: U2.21 (PA5); also elsewhere on the board
CRT: U2.24 (PC4); also elsewhere on the board
CS_BM: U2.33 (PB12); also elsewhere on the board
CardDetect: CARD1.9, R3.2, U2.56 (PB4)
ELRS_UART_RX: U2.15 (PA1); also elsewhere on the board
ELRS_UART_TX: U2.14 (PA0); also elsewhere on the board
ESC1: U2.50 (PA15); also elsewhere on the board
ESC2: U2.55 (PB3); also elsewhere on the board
ESC3: U2.16 (PA2); also elsewhere on the board
ESC4: U2.17 (PA3); also elsewhere on the board
GND: C5.2, C6.2, C7.1, C8.1, C20.2, C21.2, C22.2, C23.2, C24.2, C25.2, C26.2, C27.2, C28.2, C29.2, C30.2, C31.2, C32.2, C34.1, C35.1, CARD1.6 (VSS), CARD1.10, CARD1.11 (EH), D7.1 (K), D8.1 (K), SwBoot1.3 (A), SwReset1.1, U2.12 (VSSA), U2.18 (VSS), U2.63 (VSS), XTAL1.2, XTAL1.4; also elsewhere on the board
GPS_UART_RX: U2.30 (PB11); also elsewhere on the board
GPS_UART_TX: U2.29 (PB10); also elsewhere on the board
INT1_IMU: U2.10 (PC2); also elsewhere on the board
INT2_IMU: U2.11 (PC3); also elsewhere on the board
INT_BM: U2.9 (PC1); also elsewhere on the board
INT_MAG: U2.57 (PB5); also elsewhere on the board
MISO_BM: U2.35 (PB14); also elsewhere on the board
MISO_IMU: U2.22 (PA6); also elsewhere on the board
MOSI_BM: U2.36 (PB15); also elsewhere on the board
MOSI_IMU: U2.23 (PA7); also elsewhere on the board
unnamed: D7.2 (A), R20.2
unnamed: D8.2 (A), R19.2
unnamed: R14.1, SwBoot1.2 (B)
unnamed: C21.1, U2.31 (VCAP_1)
unnamed: C20.1, U2.47 (VCAP_2)
RX_VTX: U2.43 (PA10); also elsewhere on the board
SCL_MAG: U2.58 (PB6); also elsewhere on the board
SDA_MAG: U2.59 (PB7); also elsewhere on the board
SDIO_CLK: CARD1.5 (CLK), U2.53 (PC12)
SDIO_CMD: CARD1.3 (CMD), R6.2, U2.54 (PD2)
SDIO_D0: CARD1.7 (DAT0), R7.2, U2.39 (PC8)
SDIO_D1: CARD1.8 (DAT1), R8.2, U2.40 (PC9)
SDIO_D2: CARD1.1 (DAT2), R4.2, U2.51 (PC10)
SDIO_D3: CARD1.2 (CD/DAT3), R5.2, U2.52 (PC11)
SWCLK: U2.49 (PA14); also elsewhere on the board
SWDIO: U2.46 (PA13); also elsewhere on the board
SWD_NRST: C32.1, SwReset1.2, U2.7 (NRST); also elsewhere on the board
TELEM_ESC: U2.38 (PC7); also elsewhere on the board
TX_VTX: U2.42 (PA9); also elsewhere on the board
USB_D+: U2.45 (PA12); also elsewhere on the board
USB_D-: U2.44 (PA11); also elsewhere on the board

Notes on the sheet:
Esto es opcional, si se conecta al stm32 es una formaque te diga si hay una tarjeta insertada. pero no es necesario
Boot and Reset
MICRO SD
Datasheet and aplication notes - Vcap_1/Vcap_2: 2.2 uF low ESR <2 ohm
Especificaciones: DAT2: Bus de datos 2. CD/DAT3: Bus de datos 3 / Selección en SPI. CMD: Línea de comandos. VDD: 3.3V Alimentación (LDO de bajo ruido). CLK: Reloj del bus SDIO. VSS: Referencia de tierra común. DAT0: Bus de datos 0. DAT1: Bus de datos 1. Criterios de Diseño de Hardware (Layout) inte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

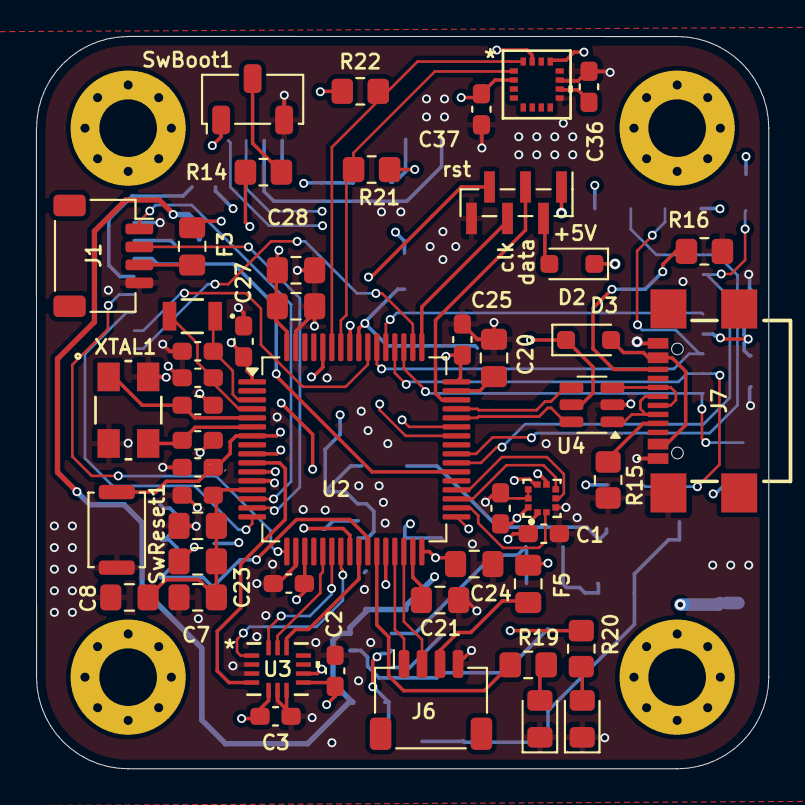
[picture p20: board Esquematico_1.kicad_pcb from above]

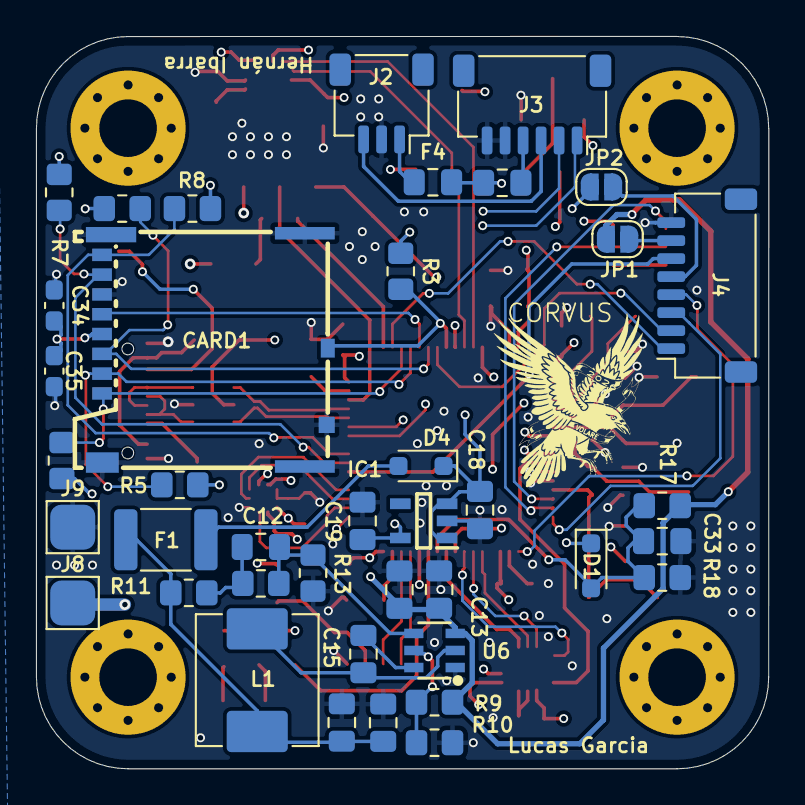
[picture p21: board Esquematico_1.kicad_pcb from below]

Board: 6 copper layers, 40.7 x 40.7 mm, 94 parts (40 on the bottom side), 77 nets.
