Lucas-el-pato/FC-DRON-P3/PinCubeMX/Core/Src/main.c

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
/* Includes ------------------------------------------------------------------*/
#include "main.h"
#include "adc.h"
#include "dma.h"
#include "i2c.h"
#include "spi.h"
#include "tim.h"
#include "usart.h"
#include "usb_device.h"
#include "gpio.h"

/* USER CODE BEGIN Includes */
#include "usbd_cdc_if.h"
#include "test_runner.h"
#include <stdio.h>
#include <string.h>
/* USER CODE END Includes */

/* USER CODE BEGIN PD */
/* Constantes movidas a los drivers en Tests/. */
/* USER CODE END PD */


void SystemClock_Config(void);
/* USER CODE BEGIN PFP */
/* Las funciones de impresion y de drivers viven en Tests/Src/.                */
/* USER CODE END PFP */

/**
  * @brief  The application entry point.
  * @retval int
  */
int main(void)
{

  /* MCU Configuration--------------------------------------------------------*/

  /* Reset of all peripherals, Initializes the Flash interface and the Systick. */
  HAL_Init();

  /* Configure the system clock */
  SystemClock_Config();

  /* Initialize all configured peripherals */
  MX_GPIO_Init();
  MX_DMA_Init();
  MX_I2C1_Init();
  MX_SPI1_Init();
  MX_UART4_Init();
  MX_USB_DEVICE_Init();
  MX_SPI2_Init();
  MX_TIM2_Init();
  MX_ADC1_Init();
  MX_USART3_UART_Init();
  MX_USART6_UART_Init();
  MX_SPI3_Init();
  /* USER CODE BEGIN 2 */
  /* CS de sensores SPI en alto (deselect). MX_GPIO_Init los deja en bajo.    */
  HAL_GPIO_WritePin(bar_cs_GPIO_Port, bar_cs_Pin, GPIO_PIN_SET);
  HAL_GPIO_WritePin(GPIOC, GPIO_PIN_5, GPIO_PIN_SET); /* IMU CS = PC5 */

  /* Despacho al test seleccionado en Tests/Inc/test_runner.h.                */
  /* test_runner_run() inicializa la consola USB CDC y nunca retorna.         */
  test_runner_run();
  /* USER CODE END 2 */

  /* Infinite loop */
  /* USER CODE BEGIN WHILE */
  while (1)
  {
    /* test_runner_run() ya consume el control; este while queda inalcanzable.*/
    /* USER CODE END WHILE */

    /* USER CODE BEGIN 3 */
  }
  /* USER CODE END 3 */
}

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
