Lucas-el-pato/FC-DRON-P3/PinCubeMX/PinCubeMX.ioc

Mcu.UserName=STM32F405RGTx
PA0-WKUP.Signal=UART4_TX
PA1.Signal=UART4_RX
PA11.Signal=USB_OTG_FS_DM
PA12.Signal=USB_OTG_FS_DP
PA13.Signal=SYS_JTMS-SWDIO
PA14.Signal=SYS_JTCK-SWCLK
PA15.GPIO_Label=M1
PA15.Signal=S_TIM2_CH1_ETR
PA2.GPIO_Label=M3
PA2.Signal=S_TIM2_CH3
PA3.GPIO_Label=M4
PA3.Signal=S_TIM2_CH4
PA5.Signal=SPI1_SCK
PA6.Signal=SPI1_MISO
PA7.Signal=SPI1_MOSI
PB0.Signal=ADCx_IN8
PB1.GPIO_Label=led_rojo
PB1.Signal=GPIO_Output
PB10.GPIO_Label=GPS_TX
PB10.Signal=USART3_TX
PB11.GPIO_Label=GPS_RX
PB11.Signal=USART3_RX
PB12.GPIO_Label=bar_cs
PB12.Signal=GPIO_Output
PB13.Signal=SPI2_SCK
PB14.Signal=SPI2_MISO
PB15.Signal=SPI2_MOSI
PB2.GPIO_Label=led_verde
PB2.Signal=GPIO_Output
PB3.GPIO_Label=M2
PB3.Signal=S_TIM2_CH2
PB4.GPIO_Label=SD_CS
PB4.Signal=GPIO_Input
PB5.GPIO_Label=MAG_INT
PB5.Signal=GPIO_Input
PB6.Signal=I2C1_SCL
PB7.Signal=I2C1_SDA
PC1.Signal=GPIO_Input
PC10.Signal=SDIO_D2
PC11.Signal=SDIO_D3
PC12.Signal=SDIO_CK
PC14-OSC32_IN.Signal=RCC_OSC32_IN
PC15-OSC32_OUT.Signal=RCC_OSC32_OUT
PC2.GPIO_Label=IMU_INT1
PC2.Signal=GPXTI2
PC3.GPIO_Label=IMU_INT2
PC3.Signal=GPXTI3
PC4.Signal=ADCx_IN14
PC5.GPIO_Label=IMU_CS
PC5.Signal=GPIO_Output
PC6.Signal=USART6_TX
PC7.Signal=USART6_RX
PC8.Signal=SDIO_D0
PC9.Signal=SDIO_D1
PD2.Signal=SDIO_CMD
PH0-OSC_IN.Signal=RCC_OSC_IN
PH1-OSC_OUT.Signal=RCC_OSC_OUT
