Lucas-el-pato/FC-DRON-P3/PinCubeMX/Core/Src/adc.c

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
/* Includes ------------------------------------------------------------------*/
#include "adc.h"

ADC_HandleTypeDef hadc1;

/* ADC1 init function */
void MX_ADC1_Init(void)
{

  ADC_ChannelConfTypeDef sConfig = {0};

  /** Configure the global features of the ADC (Clock, Resolution, Data Alignment and number of conversion)
  */
  hadc1.Instance = ADC1;
  hadc1.Init.ClockPrescaler = ADC_CLOCK_SYNC_PCLK_DIV4;
  hadc1.Init.Resolution = ADC_RESOLUTION_12B;
  hadc1.Init.ScanConvMode = DISABLE;
  hadc1.Init.ContinuousConvMode = DISABLE;
  hadc1.Init.DiscontinuousConvMode = DISABLE;
  hadc1.Init.ExternalTrigConvEdge = ADC_EXTERNALTRIGCONVEDGE_NONE;
  hadc1.Init.ExternalTrigConv = ADC_SOFTWARE_START;
  hadc1.Init.DataAlign = ADC_DATAALIGN_RIGHT;
  hadc1.Init.NbrOfConversion = 1;
  hadc1.Init.DMAContinuousRequests = DISABLE;
  hadc1.Init.EOCSelection = ADC_EOC_SINGLE_CONV;
  if (HAL_ADC_Init(&hadc1) != HAL_OK)
  {
    Error_Handler();
  }

  /** Configure for the selected ADC regular channel its corresponding rank in the sequencer and its sample time.
  */
  sConfig.Channel = ADC_CHANNEL_8;
  sConfig.Rank = 1;
  sConfig.SamplingTime = ADC_SAMPLETIME_3CYCLES;
  if (HAL_ADC_ConfigChannel(&hadc1, &sConfig) != HAL_OK)
  {
    Error_Handler();
  }
}

void HAL_ADC_MspInit(ADC_HandleTypeDef* adcHandle)
{

  GPIO_InitTypeDef GPIO_InitStruct = {0};
  if(adcHandle->Instance==ADC1)
  {
    /* ADC1 clock enable */
    __HAL_RCC_ADC1_CLK_ENABLE();

    __HAL_RCC_GPIOC_CLK_ENABLE();
    __HAL_RCC_GPIOB_CLK_ENABLE();
    /**ADC1 GPIO Configuration
    PC4     ------> ADC1_IN14
    PB0     ------> ADC1_IN8
    */
    GPIO_InitStruct.Pin = GPIO_PIN_4;
    GPIO_InitStruct.Mode = GPIO_MODE_ANALOG;
    GPIO_InitStruct.Pull = GPIO_NOPULL;
    HAL_GPIO_Init(GPIOC, &GPIO_InitStruct);

    GPIO_InitStruct.Pin = GPIO_PIN_0;
    GPIO_InitStruct.Mode = GPIO_MODE_ANALOG;
    GPIO_InitStruct.Pull = GPIO_NOPULL;
    HAL_GPIO_Init(GPIOB, &GPIO_InitStruct);

  }
}

void HAL_ADC_MspDeInit(ADC_HandleTypeDef* adcHandle)
{

  if(adcHandle->Instance==ADC1)
  {
    /* Peripheral clock disable */
    __HAL_RCC_ADC1_CLK_DISABLE();

    /**ADC1 GPIO Configuration
    PC4     ------> ADC1_IN14
    PB0     ------> ADC1_IN8
    */
    HAL_GPIO_DeInit(GPIOC, GPIO_PIN_4);

    HAL_GPIO_DeInit(GPIOB, GPIO_PIN_0);

  }
}

/* USER CODE BEGIN 1 */

uint16_t adc_crt_read_raw(void)
{
  ADC_ChannelConfTypeDef sConfig = {0};

  sConfig.Channel = ADC_CRT_CHANNEL;
  sConfig.Rank = 1;
  /* Fuente analógica del ESC: sampling corto (3 ciclos) suele ser ruidoso. */
  sConfig.SamplingTime = ADC_SAMPLETIME_84CYCLES;
  if (HAL_ADC_ConfigChannel(&hadc1, &sConfig) != HAL_OK) {
    return 0xFFFFu;
  }

  if (HAL_ADC_Start(&hadc1) != HAL_OK) {
    return 0xFFFFu;
  }
  if (HAL_ADC_PollForConversion(&hadc1, 10u) != HAL_OK) {
    (void)HAL_ADC_Stop(&hadc1);
    return 0xFFFFu;
  }

  uint16_t raw = (uint16_t)HAL_ADC_GetValue(&hadc1);
  (void)HAL_ADC_Stop(&hadc1);
  return raw;
}

uint16_t adc_crt_raw_to_ca(uint16_t raw)
{
  if (raw == 0xFFFFu) {
    return 0u;
  }

  /* V_mv = raw * Vref / 4095 ; I_ca = V_mv * 100 / 11.75 = V_mv * 10000 / 1175 */
  uint32_t v_mv = ((uint32_t)raw * ADC_VREF_MV) / ADC_MAX_COUNTS;
  uint32_t i_ca = (v_mv * 10000u) / ADC_CRT_MV_PER_A_X100;
  if (i_ca > 65535u) {
    i_ca = 65535u;
  }
  return (uint16_t)i_ca;
}

uint16_t adc_crt_read_ca(void)
{
  return adc_crt_raw_to_ca(adc_crt_read_raw());
}

/* USER CODE END 1 */
