Lucas-el-pato/FC-DRON-P3/PinCubeMX/Tests/Src/test_motors.c

/**
 ******************************************************************************
 * @file    test_motors.c
 * @brief   Bench test de un ESC Hobbywing XRotor FPV G2 con DShot + KISS telem.
 *
 *          ATENCION DE SEGURIDAD:
 *            - SACAR LAS HELICES antes de energizar.
 *            - Conectar solo la senal del ESC seleccionado (+ GND compartido).
 *            - Flashear y arrancar el firmware ANTES de alimentar el ESC:
 *              Hobbywing/AM32 detecta el protocolo al encender.
 *            - Si cambia SelectEsc o el protocolo, cortar alimentacion del ESC,
 *              reflash, arrancar MCU, y recien entonces alimentar el ESC.
 *
 *          Cableado telemetria:
 *            ESC T / TELEMETRY -> PC7 (USART6_RX @ 115200)
 *            ESC GND           -> GND
 *
 *          Cableado corriente CRT (ADC):
 *            ESC CRT           -> PC4 (ADC1_IN14), escala 11.75 mV/A
 *
 *          Configuracion compile-time (abajo):
 *            - SelectEsc: 1=M1 .. 4=M4 (default 1 = M1/PA15)
 *            - MOTORS_TEST_PROTOCOL: DShot300 (default) o DShot600
 *
 *          Secuencia:
 *            1. Aviso props-off + power-cycle note
 *            2. motors_init + telemtry_init
 *            3. 5 s de throttle=0 (armado), pidiendo telem cada N frames
 *            4. Ramp low controlado solo en el ESC seleccionado
 *            5. Vuelta a 0 y mantenimiento continuo de stop
 ******************************************************************************
 */

#include "adc.h"
#include "console.h"
#include "driver_motors.h"
#include "telemtry.h"

#include <stddef.h>

/* ============================================================== */
/* CONFIGURACION DEL TEST (compile-time)                          */
/* ============================================================== */

/* 1=M1/PA15, 2=M2/PB3, 3=M3/PA2, 4=M4/PA3 */
#ifndef SelectEsc
#define SelectEsc 3
#endif

/* Dejar UNA sola linea activa: */
#define MOTORS_TEST_USE_DSHOT300 1
/* #define MOTORS_TEST_USE_DSHOT600 1 */

#if defined(MOTORS_TEST_USE_DSHOT600) && MOTORS_TEST_USE_DSHOT600
#define MOTORS_TEST_PROTOCOL MOTORS_PROTO_DSHOT600
#elif defined(MOTORS_TEST_USE_DSHOT300) && MOTORS_TEST_USE_DSHOT300
#define MOTORS_TEST_PROTOCOL MOTORS_PROTO_DSHOT300
#else
#error "Define MOTORS_TEST_USE_DSHOT300 or MOTORS_TEST_USE_DSHOT600"
#endif

#if (SelectEsc < 1) || (SelectEsc > 4)
#error "SelectEsc must be 1 (M1), 2 (M2), 3 (M3), or 4 (M4)"
#endif

/* ============================================================== */

#define ESC_ARM_TIME_MS        5000u
#define RAMP_STEP_TIME_MS      2000u
#define FRAME_PERIOD_MS        1u
#define TELEM_EVERY_N_FRAMES   20u   /* ~50 Hz request @ 1 ms frame */
#define TELEM_DIAG_PERIOD_MS   1000u
#define CRT_PRINT_PERIOD_MS    200u  /* I_crt solo si aun no hay frame KISS */
#define MAX_TEST_THROTTLE_PCT  50u
#define DSHOT_MAX_SAFE_VALUE   1024u

static uint16_t throttle_to_dshot(uint8_t percent)
{
    if (percent == 0u) {
        return 0u;
    }
    if (percent > MAX_TEST_THROTTLE_PCT) {
        percent = MAX_TEST_THROTTLE_PCT;
    }

    const uint32_t span = 2047u - 48u;
    uint16_t value = (uint16_t)(48u + (span * (uint32_t)percent) / 100u);
    if (value > DSHOT_MAX_SAFE_VALUE) {
        value = DSHOT_MAX_SAFE_VALUE;
    }
    return value;
}

static void print_telem_if_ready(void)
{
    telemtry_data_t td;
    if (telemtry_poll(&td) == TELEMTRY_OK) {
        const uint16_t crt_raw = adc_crt_read_raw();
        const uint16_t i_crt_ca = adc_crt_raw_to_ca(crt_raw);
        console_printf(
            "TELEM T=%d C  V=%u.%02u V  I=%u.%02u A  mAh=%u  eRPM=%lu  RPM=%lu  "
            "I_crt=%u.%02u A  (raw=%u)\r\n",
            (int)td.temperature_c,
            (unsigned)(td.voltage_cv / 100u),
            (unsigned)(td.voltage_cv % 100u),
            (unsigned)(td.current_ca / 100u),
            (unsigned)(td.current_ca % 100u),
            (unsigned)td.consumption_mah,
            (unsigned long)td.erpm,
            (unsigned long)td.rpm,
            (unsigned)(i_crt_ca / 100u),
            (unsigned)(i_crt_ca % 100u),
            (unsigned)crt_raw);
    }
}

/* Mientras no haya frames validos, reportar el estado crudo del RX: distingue
   "no llega nada por PC7" (rx=0) de "llega pero no sincroniza" (rx>0). */
static void print_telem_diag_if_due(void)
{
    static uint32_t last_ms = 0u;

    if (g_telemValidCount != 0u) {
        return;
    }
    if ((HAL_GetTick() - last_ms) < TELEM_DIAG_PERIOD_MS) {
        return;
    }
    last_ms = HAL_GetTick();

    const uint16_t crt_raw = adc_crt_read_raw();
    const uint16_t i_crt_ca = adc_crt_raw_to_ca(crt_raw);
    console_printf("TELEM diag: rx=%lu crcskip=%lu uarterr=%lu pend=%u "
                   "I_crt=%u.%02u A (raw=%u) (sin frame valido)\r\n",
                   (unsigned long)g_telemByteCount,
                   (unsigned long)g_telemCrcErrCount,
                   (unsigned long)g_telemUartErrCount,
                   (unsigned)telemtry_rx_pending(),
                   (unsigned)(i_crt_ca / 100u),
                   (unsigned)(i_crt_ca % 100u),
                   (unsigned)crt_raw);
}

/* Si ya hay telem KISS, I_crt viaja en esa linea. Si no, imprimir CRT periodico. */
static void print_crt_if_due(void)
{
    static uint32_t last_ms = 0u;

    if (g_telemValidCount != 0u) {
        return;
    }
    if ((HAL_GetTick() - last_ms) < CRT_PRINT_PERIOD_MS) {
        return;
    }
    last_ms = HAL_GetTick();

    const uint16_t crt_raw = adc_crt_read_raw();
    const uint16_t i_crt_ca = adc_crt_raw_to_ca(crt_raw);
    console_printf("I_crt=%u.%02u A  (raw=%u)\r\n",
                   (unsigned)(i_crt_ca / 100u),
                   (unsigned)(i_crt_ca % 100u),
                   (unsigned)crt_raw);
}

static mot_status_t hold_throttle_ms(uint16_t throttle, uint32_t duration_ms)
{
    const uint32_t start = HAL_GetTick();
    uint32_t frame = 0u;

    while ((HAL_GetTick() - start) < duration_ms) {
        const bool want_telem = ((frame % TELEM_EVERY_N_FRAMES) == 0u);
        mot_status_t st = motors_set_throttle_telem(throttle, want_telem);
        if (st != MOT_OK) {
            return st;
        }

        /* El DMA circular sigue capturando mientras se imprime o se duerme. */
        print_telem_if_ready();
        print_telem_diag_if_due();
        print_crt_if_due();

        HAL_Delay(FRAME_PERIOD_MS);
        frame++;
    }
    return MOT_OK;
}

static mot_status_t run_ramp_step(uint8_t percent)
{
    uint16_t value = throttle_to_dshot(percent);
    console_printf("Throttle %u%% -> DShot %u (solo %s)\r\n",
                   (unsigned)percent,
                   (unsigned)value,
                   motors_esc_pin_name(SelectEsc));
    return hold_throttle_ms(value, RAMP_STEP_TIME_MS);
}

void test_motors_run(void)
{
    const motors_protocol_t protocol = MOTORS_TEST_PROTOCOL;

    console_banner("Motores ESC DShot + KISS telem");

    console_print("========================================\r\n");
    console_print(" ATENCION: SACAR LAS HELICES\r\n");
    console_print(" GND compartido; una sola senal ESC\r\n");
    console_print(" ESC T -> PC7 (USART6_RX 115200)\r\n");
    console_print(" ESC CRT -> PC4 (ADC1_IN14, 11.75 mV/A)\r\n");
    console_print(" Firmware ANTES de alimentar el ESC\r\n");
    console_print(" (AM32 detecta protocolo al boot)\r\n");
    console_print("========================================\r\n");

    console_printf("Protocolo : %s\r\n", motors_protocol_name(protocol));
    console_printf("SelectEsc : %u (%s)\r\n",
                   (unsigned)SelectEsc,
                   motors_esc_pin_name(SelectEsc));
    console_printf("Ramp max  : %u%% (DShot capped @ %u)\r\n",
                   (unsigned)MAX_TEST_THROTTLE_PCT,
                   (unsigned)DSHOT_MAX_SAFE_VALUE);
    console_printf("Motor poles (RPM): %u\r\n", (unsigned)TELEMTRY_MOTOR_POLES);

    mot_status_t st = motors_init(protocol, (uint8_t)SelectEsc);
    if (st != MOT_OK) {
        console_printf("motors_init fallo (codigo=%d)\r\n", (int)st);
        console_result(false, "fallo iniciando TIM2/DMA DShot");
        while (1) {
            HAL_Delay(500u);
        }
    }

    if (telemtry_init() != TELEMTRY_OK) {
        console_result(false, "fallo iniciando DMA de USART6 RX");
        while (1) {
            HAL_Delay(500u);
        }
    }
    console_result(true, "USART6 RX + DMA listo para KISS telem (PC7)");

    console_printf("Armando %lu ms a throttle=0...\r\n",
                   (unsigned long)ESC_ARM_TIME_MS);
    st = hold_throttle_ms(0u, ESC_ARM_TIME_MS);
    if (st != MOT_OK) {
        console_printf("armado fallo (codigo=%d)\r\n", (int)st);
        console_result(false, "fallo durante armado throttle=0");
        while (1) {
            HAL_Delay(500u);
        }
    }
    console_result(true, "ESC armado (throttle=0)");

    static const uint8_t ramp_up[] = {0u, 0u, 0u, 15u, 30u, 60u, 80u, 100u};
    static const uint8_t ramp_down[] = {80u, 60u, 40u, 20u, 10u, 0u, 0u, 0u};

    console_print("Ramp UP\r\n");
    for (size_t i = 0u; i < (sizeof(ramp_up) / sizeof(ramp_up[0])); ++i) {
        st = run_ramp_step(ramp_up[i]);
        if (st != MOT_OK) {
            console_printf("ramp UP fallo (codigo=%d)\r\n", (int)st);
            console_led_fail();
            break;
        }
    }

    if (st == MOT_OK) {
        console_print("Ramp DOWN\r\n");
        for (size_t i = 0u; i < (sizeof(ramp_down) / sizeof(ramp_down[0])); ++i) {
            st = run_ramp_step(ramp_down[i]);
            if (st != MOT_OK) {
                console_printf("ramp DOWN fallo (codigo=%d)\r\n", (int)st);
                console_led_fail();
                break;
            }
        }
    }

    console_print("Vuelta a throttle=0; mantengo stop + telem.\r\n");
    console_result(st == MOT_OK, (st == MOT_OK) ? "secuencia DShot OK"
                                                 : "secuencia DShot con errores");

    uint32_t frame = 0u;
    while (1) {
        (void)motors_set_throttle_telem(
            0u, ((frame % TELEM_EVERY_N_FRAMES) == 0u));
        print_telem_if_ready();
        print_telem_diag_if_due();
        print_crt_if_due();
        HAL_Delay(FRAME_PERIOD_MS);
        frame++;
    }
}
