Lucas-el-pato/FC-DRON-P3/PinCubeMX/Tests/Inc/driver_imu.h

/**
 ******************************************************************************
 * @file    driver_imu.h
 * @brief   Driver de la IMU LSM6DSV16X (acelerometro + giroscopo).
 *
 *          IMPORTANTE: la PCB tiene MISO/MOSI cruzados respecto al .ioc.
 *          Por eso el driver NO usa el periferico SPI1 sino bit-bang por
 *          GPIO con roles logicos invertidos. Ver driver_imu.c.
 *
 *          Pines fisicos:
 *            PA5 (CubeMX: SPI1_SCK)   -> SCK  del IMU      (bit-bang output)
 *            PA6 (CubeMX: SPI1_MISO)  -> SDI  del IMU      (bit-bang MOSI)
 *            PA7 (CubeMX: SPI1_MOSI)  -> SDO  del IMU      (bit-bang MISO)
 *            PC5 (GPIO output)        -> CS   del IMU      (active low)
 *            PC2 (INT1, no usado)
 *            PC3 (INT2, no usado)
 *
 *          Registros utilizados (datasheet LSM6DSV16X, Rev 4):
 *            WHO_AM_I       = 0x0F  -> debe leer 0x70
 *            CTRL1 (XL ODR) = 0x10
 *            CTRL2 (G  ODR) = 0x11
 *            CTRL3 (BDU/IF) = 0x12
 *            OUTX_L_G       = 0x22..0x27 (giro X,Y,Z LSB/MSB)
 *            OUTX_L_A       = 0x28..0x2D (accel X,Y,Z LSB/MSB)
 ******************************************************************************
 */

#ifndef TESTS_INC_DRIVER_IMU_H_
#define TESTS_INC_DRIVER_IMU_H_

#include "main.h"
#include <stdint.h>
#include <stdbool.h>

#ifdef __cplusplus
extern "C" {
#endif

/* Identidad. */
#define IMU_REG_WHO_AM_I      0x0Fu
#define IMU_WHO_AM_I_VALUE    0x70u

/* Control registers (LSM6DSV16X layout, distinto del DSO/DSL):
 *   CTRL1 [7:4]=OP_MODE_XL [3:0]=ODR_XL  (FS_XL NO esta aca, va en CTRL8)
 *   CTRL2 [7:4]=OP_MODE_G  [3:0]=ODR_G   (FS_G  NO esta aca, va en CTRL6)
 *   CTRL3 [7]=BOOT [6]=BDU [2]=IF_INC [0]=SW_RESET
 *   CTRL6 [3:0]=FS_G    (gyro full-scale)
 *   CTRL8 [1:0]=FS_XL   (accel full-scale)
 */
#define IMU_REG_CTRL1         0x10u  /* OP_MODE_XL + ODR_XL */
#define IMU_REG_CTRL2         0x11u  /* OP_MODE_G  + ODR_G  */
#define IMU_REG_CTRL3         0x12u  /* BDU, IF_INC, SW_RESET, BOOT */
#define IMU_REG_CTRL6         0x15u  /* FS_G (gyro full-scale) */
#define IMU_REG_CTRL8         0x17u  /* FS_XL (accel full-scale) */

/* Status (data-ready flags). */
#define IMU_REG_STATUS        0x1Eu  /* bit0=XLDA bit1=GDA */
#define IMU_STATUS_XLDA       (1u << 0)
#define IMU_STATUS_GDA        (1u << 1)

/* Output registers. */
#define IMU_REG_OUTX_L_G      0x22u  /* gyro X LSB */
#define IMU_REG_OUTX_L_A      0x28u  /* accel X LSB */

/* Resultado de operaciones. */
typedef enum {
    IMU_OK = 0,
    IMU_ERR_SPI,
    IMU_ERR_WHO_AM_I,
    IMU_ERR_TIMEOUT
} imu_status_t;

/* Lectura de los 6 ejes (raw, signed 16-bit). */
typedef struct {
    int16_t gx;
    int16_t gy;
    int16_t gz;
    int16_t ax;
    int16_t ay;
    int16_t az;
} imu_sample_t;

/* ------------------------------------------------------------------------- */
/* Inicializa el IMU:                                                         */
/*  - Pone CS en alto                                                         */
/*  - Verifica WHO_AM_I                                                       */
/*  - Soft reset + espera                                                     */
/*  - Habilita IF_INC y BDU                                                   */
/*  - XL: ODR 104 Hz, FS +/-4 g                                               */
/*  - G : ODR 104 Hz, FS +/-500 dps                                           */
/* Devuelve IMU_OK o codigo de error.                                         */
/* ------------------------------------------------------------------------- */
imu_status_t imu_init(void);

/* Lee un registro de 8 bits. */
imu_status_t imu_read_reg(uint8_t reg, uint8_t *value);

/* Escribe un registro de 8 bits. */
imu_status_t imu_write_reg(uint8_t reg, uint8_t value);

/* Lee multiples bytes a partir de reg (con auto-incremento del IMU). */
imu_status_t imu_read_burst(uint8_t reg, uint8_t *buf, uint16_t len);

/* Lee el byte WHO_AM_I y compara con el valor esperado. */
imu_status_t imu_check_who_am_i(uint8_t *who);

/* Lee gyro+accel en un solo burst. */
imu_status_t imu_read_sample(imu_sample_t *out);

/* Lee n muestras independientes (esperando data-ready) y devuelve el
 * promedio. Reduce ruido por sqrt(n). Bloqueante: tarda aproximadamente
 * n * (1/ODR) ms (al ODR de 120 Hz, n=32 -> ~270 ms).                     */
imu_status_t imu_read_sample_avg(imu_sample_t *out, uint8_t n_samples);

#ifdef __cplusplus
}
#endif

#endif /* TESTS_INC_DRIVER_IMU_H_ */
