Lucas-el-pato/FC-DRON-P3/PinCubeMX/Tests/Inc/test_crsf_telem.h

/**
 ******************************************************************************
 * @file    test_crsf_telem.h
 * @brief   Test de telemetria CRSF (actitud + baro) hacia SuperD ELRS.
 ******************************************************************************
 */

#ifndef TESTS_INC_TEST_CRSF_TELEM_H_
#define TESTS_INC_TEST_CRSF_TELEM_H_

#ifdef __cplusplus
extern "C" {
#endif

void test_crsf_telem_run(void);

#ifdef __cplusplus
}
#endif

#endif /* TESTS_INC_TEST_CRSF_TELEM_H_ */
