Lucas-el-pato/FC-DRON-P3/PinCubeMX/Tests/Inc/test_runner.h

/**
 ******************************************************************************
 * @file    test_runner.h
 * @brief   Selector de test por #define.
 *
 *          Descomentar UNA sola macro TEST_SELECT_xxx antes de compilar.
 *          test_runner_run() invoca la funcion test_xxx_run() correspondiente
 *          y nunca retorna (cada test_xxx_run() corre un bucle infinito al
 *          final).
 *
 *          Si no se define ninguna, el runner imprime un mensaje, parpadea
 *          el LED rojo y queda colgado.
 ******************************************************************************
 */

#ifndef TESTS_INC_TEST_RUNNER_H_
#define TESTS_INC_TEST_RUNNER_H_

#ifdef __cplusplus
extern "C" {
#endif

/* ============================================================== */
/* SELECCION DE TEST: dejar UNA sola linea descomentada.          */
/* ============================================================== */
//#define TEST_SELECT_IMU
//#define TEST_SELECT_IMU_DIAG
//#define TEST_SELECT_BARO
//#define TEST_SELECT_MAG
//#define TEST_SELECT_GPS
//#define TEST_SELECT_RC
//#define TEST_SELECT_MOTORS
//#define TEST_SELECT_TELEMETRY
#define TEST_SELECT_CRSF_TELEM
/* ============================================================== */

/* Punto de entrada del runner; se llama desde main(). No retorna. */
void test_runner_run(void);

/* Prototipos de cada test (definidos en test_xxx.c). */
void test_imu_run(void);
void test_imu_diag_run(void);
void test_baro_run(void);
void test_mag_run(void);
void test_gps_run(void);
void test_rc_run(void);
void test_motors_run(void);
void test_telemetry_run(void);
void test_crsf_telem_run(void);

#ifdef __cplusplus
}
#endif

#endif /* TESTS_INC_TEST_RUNNER_H_ */
