Lucas-el-pato/FC-DRON-P3/(commit log)

2026-02-21 Added Diagrama de bloques FC Dron.drawio.svg
2026-02-21 Update Diagrama de bloques FC Dron.drawio.svg
2026-02-21 Carga de esquematico
    prueba de carga de esquematico
    [Esquematico_1.kicad_pcb, Esquematico_1.kicad_sch]
2026-02-21 Add file patterns to .gitignore
    Ignora tipos de archivos generados por kicad para que no sea demasiado pesado
2026-02-21 Testing add a MCU
    [Esquematico_1.kicad_pcb, Esquematico_1.kicad_sch]
2026-02-21 carga de algunos datasheets y footprints
2026-02-21 Esquematico 2 en kicad 10
    kicad 10, pruba del footprint y esqumatico del magnetometro descargando en formato altium
    [Esquematico_2_k10.kicad_pcb, Esquematico_2_k10.kicad_sch]
2026-02-21 Carga de esqumaticos
    Carga de esquematicos
    GPS
    GYRO
    MAG
    BARO
    USB
    MICRO
    BOTON
2026-02-21 Nueva carga de esquematicos y footprints
    [Esquematico_2_k10.kicad_pcb, Esquematico_2_k10.kicad_sch]
2026-02-21 Se agregaron las páginas para el trabajo
    [Esquematico_1.kicad_sch, microcontrolador.kicad_sch, power.kicad_sch, sensores_.kicad_sch]
2026-02-23 Carga de esquematicos y footprint para kicad 9
2026-02-23 Carga de footprints
    [microcontrolador.kicad_sch, sensores_.kicad_sch]
2026-02-23 Kicad changes
    [Esquematico_1.kicad_pcb, sensores_.kicad_sch]
2026-02-24 Conexion esqumatica del Magnetometro
    [sensores_.kicad_sch]
2026-02-24 Conexionado esquematico del Barometro
    [Esquematico_1.kicad_pcb, microcontrolador.kicad_sch, sensores_.kicad_sch]
2026-02-24 Conexion esquematica Micro SD
    [microcontrolador.kicad_sch, sensores_.kicad_sch]
2026-02-24 Update Micro SD
    [microcontrolador.kicad_sch]
2026-02-24 Descripcion de esquematicos
    [microcontrolador.kicad_sch, sensores_.kicad_sch]
2026-02-24 Update Descricion de esquematicos
    [microcontrolador.kicad_sch, sensores_.kicad_sch]
2026-02-24 General aplication and ICM footprint
    [microcontrolador.kicad_sch, sensores_.kicad_sch]
2026-02-25 Update squematic
    [microcontrolador.kicad_sch]
2026-02-25 OSD added
    [Esquematico_1.kicad_sch, jst_cam.kicad_sch, microcontrolador.kicad_sch]
2026-02-25 Update de algo nsq que puta
    [jst_cam.kicad_sch]
2026-02-25 Update esquematico
    [Esquematico_1.kicad_sch, microcontrolador.kicad_sch, sensores_.kicad_sch]
2026-02-25 Update Power
    [power.kicad_sch]
2026-02-26 Update footprint library
    [1TS003B-1400-3500A1_1TS003B-1400-3500A.schdoc, 503398-18921_503398-1892.schdoc, BMP388.step, Esquematico_1.kicad_pcb, Esquematico_1.kicad_sch, HX-TYPE-C 24P-1.6 USB C 3.2 REC, HORZ1_HX-TYPE-C 24P-1.6 USB C 3.2 REC, HORZ.schdoc, ICM-42688-P.step, ICM-42688-PC1_ICM-42688-PC.schdoc]
2026-02-27 Update Diagrama de bloques FC Dron
2026-02-27 Diagrama de bloques FC Dron.drawio.svg
2026-02-27 Chau OSD
    [jst_cam.kicad_sch]
2026-02-28 Actualización MCU, se colocaron correctamente los capacitores de desacoplo
    [microcontrolador.kicad_sch]
2026-03-01 Cristales y algunas correciones
    [microcontrolador.kicad_sch]
2026-03-01 Correciones de tags
    [jst_cam.kicad_sch, microcontrolador.kicad_sch, power.kicad_sch, sensores_.kicad_sch]
2026-03-02 Inlcluí el SW
    [microcontrolador.kicad_sch]
2026-03-02 UBS, botón de reset y boot, también por fin SWD
    [jst_cam.kicad_sch]
2026-03-02 Cambio de ESC
    [jst_cam.kicad_sch]
2026-03-03 Cristales y arreglo de los simbolos que no estaban en referencia
    [ABMM-8.000MHZ-D-4-T.stp, EDI2CAP.CFG, abmm25000mhzb2t.psm, chips.prt, microcontrolador.kicad_sch]
2026-03-05 Update Circuito de medicion de bateria
    [jst_cam.kicad_sch, power.kicad_sch]
2026-03-06 Conexiones con MCU, IMU, VTX, ELRS y Magnometro
    [MAX-M10S-00B.STEP, MAX-M10S-00B.step, microcontrolador.kicad_sch, sensores_.kicad_sch]
2026-03-08 último sensor conectado, y le quité los colores al net_signal xdd
    [jst_cam.kicad_sch, microcontrolador.kicad_sch, power.kicad_sch, sensores_.kicad_sch]
2026-03-08 Update llamada
    [Esquematico_1.kicad_sch, jst_cam.kicad_sch, microcontrolador.kicad_sch, sensores_.kicad_sch]
2026-03-08 Update Fisubles
    [jst_cam.kicad_sch, power.kicad_sch]
2026-03-09 Cambios insignificantes
    [sensores_.kicad_sch]
2026-03-10 Cambio del cristal por n-ésima vez
    [AP2112K-3.3TRG1.SchLib, AP2112K-3.3TRG1.stp, ECS-80-12_ECS.step, EDI2CAP.CFG, SOT95P285X140-5N.PcbLib, XTAL_NX3215SA_NDK.step, chips.prt, jst_cam.kicad_sch]
2026-03-10 Actualizacion de PinCubeMX
2026-03-10 Update polyfuse
    [jst_cam.kicad_sch]
2026-03-10 asignación de footprints
    [microcontrolador.kicad_sch]
2026-03-10 Update Footprint sw reset
    [microcontrolador.kicad_sch]
2026-03-10 Update footprint sw rst
    [Esquematico_1.kicad_pcb, Esquematico_1.kicad_sch, microcontrolador.kicad_sch]
2026-03-10 USB 16 Pin
    [jst_cam.kicad_sch]
2026-03-10 LDS y gran corrección de errores del esquemático
    [jst_cam.kicad_sch, microcontrolador.kicad_sch, power.kicad_sch, sensores_.kicad_sch]
2026-03-11 Todos los footprints menos ESC
    [EDI2CAP.CFG, Esquematico_1.kicad_pcb, Esquematico_1.kicad_sch, USB4940-00-A.SchLib, USB4940-00-A.stp, USB494000A.PcbLib, chips.prt, jst_cam.kicad_sch]
2026-03-11 Update pcb
    [Esquematico_1.kicad_pcb]
2026-03-11 Update PCB y JST
    [Esquematico_1.kicad_pcb, jst_cam.kicad_sch]
2026-03-12 Cambios netclasses, rules en el PCB, conección de los cristales
    [Esquematico_1.kicad_pcb, microcontrolador.kicad_sch, power.kicad_sch, sensores_.kicad_sch]
2026-03-13 BIG Update conexionado MCU y PCB
    [Esquematico_1.kicad_pcb, Esquematico_1.kicad_sch, jst_cam.kicad_sch, microcontrolador.kicad_sch]
2026-03-13 Push prueba PCB LUCAS
    [Esquematico_1.kicad_pcb]
2026-03-13 Diodo de mierda
    [Esquematico_1.kicad_pcb, power.kicad_sch]
2026-03-13 Update PCB backlayer
    [Esquematico_1.kicad_pcb, jst_cam.kicad_sch, power.kicad_sch]
2026-03-13 update pcb lucas
    [Esquematico_1.kicad_pcb]
2026-03-13 Cristal corregido
    [Esquematico_1.kicad_pcb, microcontrolador.kicad_sch, sensores_.kicad_sch]
2026-03-14 Re ubicación de componentes,falta IMU, MAG y ferrita
    [Esquematico_1.kicad_pcb]
2026-03-14 Update buck y LDO
    [Esquematico_1.kicad_pcb, power.kicad_sch]
2026-03-14 Update kilombo
    [Esquematico_1.kicad_pcb]
2026-03-14 Magnometro listo y luces led
    [Esquematico_1.kicad_pcb, microcontrolador.kicad_sch]
2026-03-14 Reposicionamiento de los LEDS jjji
    [Esquematico_1.kicad_pcb]
2026-03-14 Update version con magnometro
    [Esquematico_1.kicad_pcb]
2026-03-14 Update conectado el cir. med. de bat
    [microcontrolador.kicad_sch]
2026-03-15 Update ruteado PCB
    [Esquematico_1.kicad_pcb]
2026-03-15 Corrección pistas de 90 grados y Power plane 3,3V
    [Esquematico_1.kicad_pcb, microcontrolador.kicad_sch]
2026-03-15 Re ordenar para hacer el fucking SPI del IMU
    [Esquematico_1.kicad_pcb]
2026-03-16 Re size la placa, obs verificar el tamaño xd, solamente falta USB y VCC
    [Esquematico_1.kicad_pcb]
2026-03-16 Update arreglo de errores
    [Esquematico_1.kicad_pcb, jst_cam.kicad_sch]
2026-03-16 Update pcb 0 errores
    8========D
    [Esquematico_1.kicad_pcb]
2026-03-16 Pequeños retoques de los nombres
    [Esquematico_1.kicad_pcb]
2026-03-16 Add 3d model pa
    [5033981892.stp, Esquematico_1.kicad_pcb, LGA14_2P5X3X0P91_TDK.step, c-2295018-2-b-3d.stp]
2026-03-17 Cambio de la SD, re ruteo del ESC para mayor fiabilidad, correción en el clearence
    [Esquematico_1.kicad_pcb, microcontrolador.kicad_sch, sensores_.kicad_sch]
2026-03-17 Cambios menores
    [Esquematico_1.kicad_pcb]
2026-03-19 Correcciones menores
    [Esquematico_1.kicad_pcb]
2026-03-19 Eliminacion de carpeta Esquematico_2
    [Esquematico_2_k10.kicad_pcb, Esquematico_2_k10.kicad_sch]
2026-03-20 Cambios de Diodos
    [Esquematico_1.kicad_pcb, Esquematico_1.kicad_sch, jst_cam.kicad_sch, power.kicad_sch]
2026-03-27 Correccion de tamaño
    [Esquematico_1.kicad_pcb]
2026-03-27 Asesinato de cantos
    [Esquematico_1.kicad_pcb]
2026-03-28 Cambios de todas las vías
    [Esquematico_1.kicad_pcb, bom.csv, designators.csv, positions.csv]
2026-03-29 Cambio de magnometro :c
    [Esquematico_1.kicad_pcb, MMC5983MA_MEM.step, jst_cam.kicad_sch, microcontrolador.kicad_sch, sensores_.kicad_sch]
2026-04-01 Cambio de IMU, creación del BOM
    [Esquematico_1.csv, Esquematico_1.kicad_pcb, Esquematico_1.kicad_sch, LGA-14L_STM.step, jst_cam.kicad_sch, microcontrolador.kicad_sch, power.kicad_sch, sensores_.kicad_sch]
2026-04-16 Pequeños cambios en los silkscreen
    [Esquematico_1.kicad_pcb]
2026-04-18 Silkscreen y huellas en general de la imagenes
    [Esquematico_1.kicad_pcb]
2026-04-21 crow final
    [Esquematico_1.kicad_pcb]
2026-04-22 Correccion final
    2 hermana
    [Esquematico_1.kicad_pcb, bom.csv, designators.csv, positions.csv]
2026-04-22 error fixed
    [Esquematico_1.kicad_pcb]
2026-04-22 USB fix
    [Esquematico_1.kicad_pcb]
2026-04-23 ultimo retoque final
    [Esquematico_1.kicad_pcb, bom.csv, designators.csv, positions.csv]
2026-05-27 Commit toqueteo: todo menos ELRS y Motor y SD
2026-07-24 DShot300 for esp32S3
2026-07-24 Feature: Esc for STM32
2026-08-24 feat: Codigo de Pruebas_firmware1
